MohamedHassan-coder/5-Axis-CNC/Linear_Guide & Rails/Linear Bearing in Guide Rail - 20mm.JPG

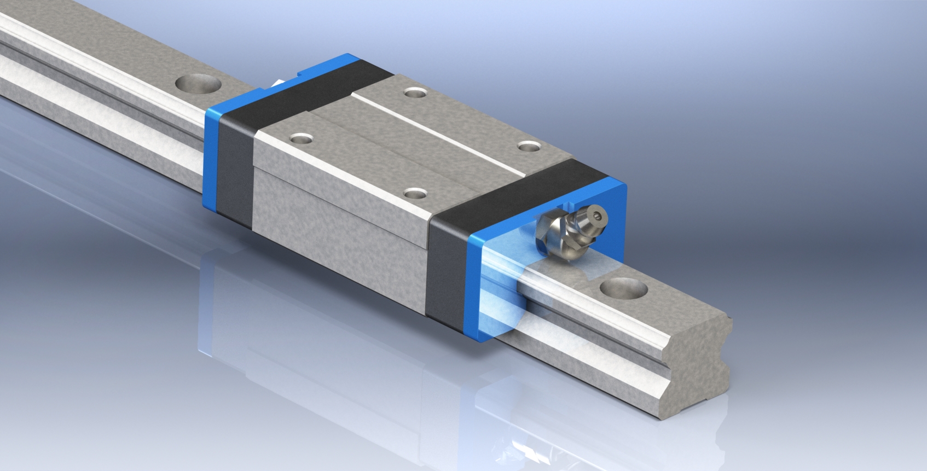
Linear_Guide & Rails/Linear Bearing in Guide Rail - 20mm.JPG
