MohamedHassan-coder/5-Axis-CNC/Linear_Guide & Rails/Linear Bearing - 20mm.JPG

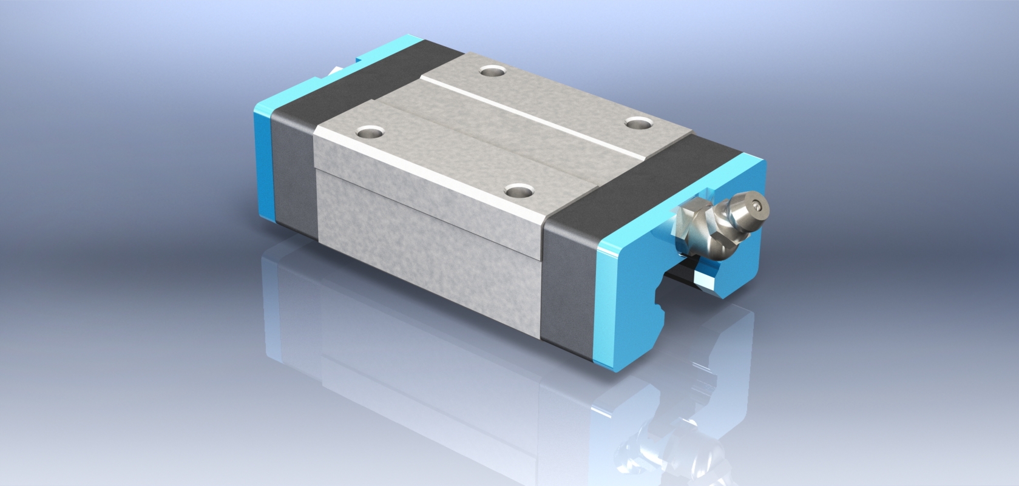
Linear_Guide & Rails/Linear Bearing - 20mm.JPG
