MohamedHassan-coder/5-Axis-CNC/Collet & Chuck/Capture- 1.PNG

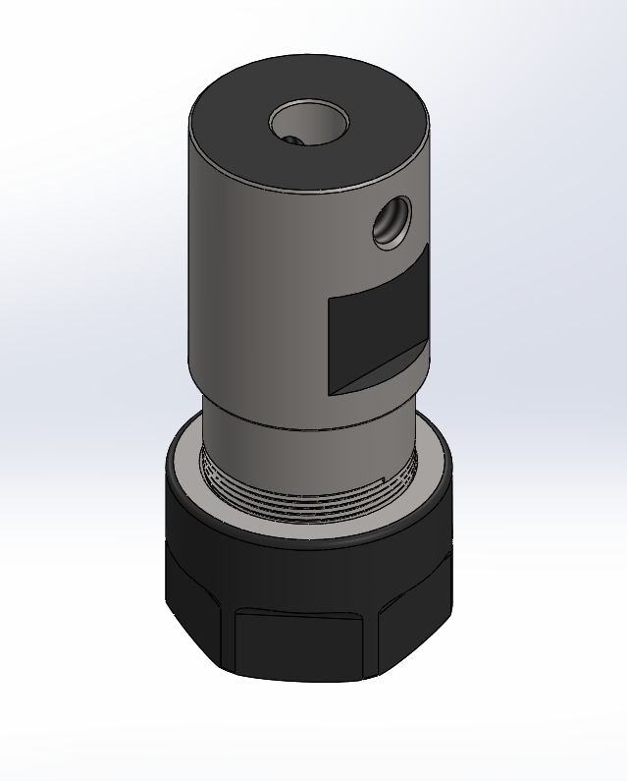
Collet & Chuck/Capture- 1.PNG
