MohamedHassan-coder/5-Axis-CNC/Collet & Chuck/Capture- 2.PNG

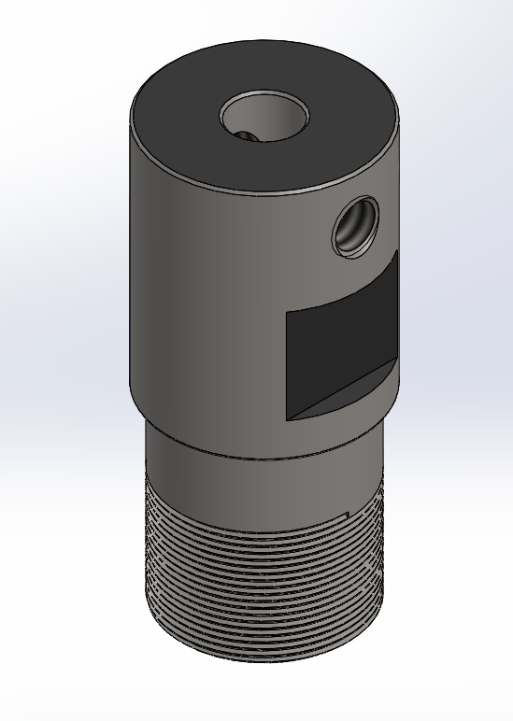
Collet & Chuck/Capture- 2.PNG
