MohamedHassan-coder/5-Axis-CNC/Collet & Chuck/Capture- 3.PNG

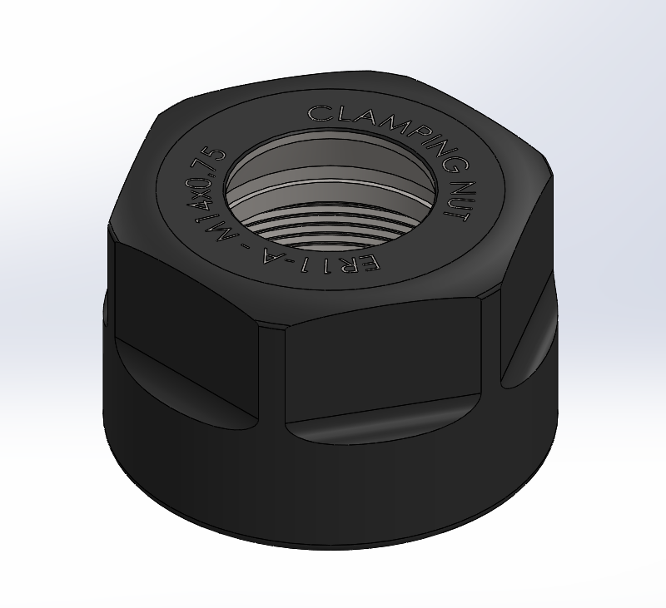
Collet & Chuck/Capture- 3.PNG
