MohamedHassan-coder/5-Axis-CNC/Collet & Chuck/ER11 Collet Set.png

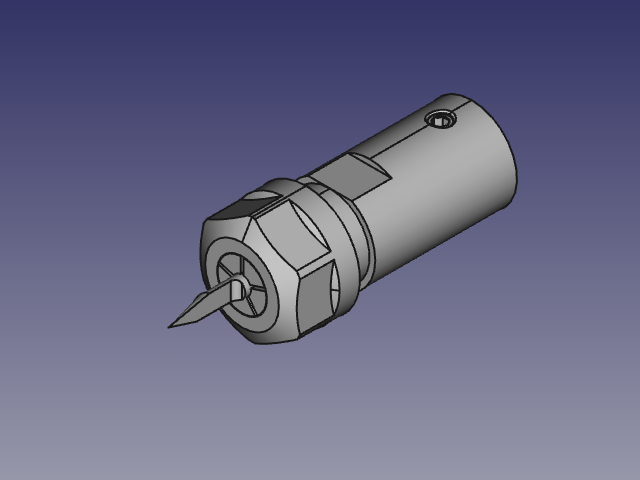
Collet & Chuck/ER11 Collet Set.png
