MohamedHassan-coder/5-Axis-CNC/Lead Screw & Nut/LeadScrew 8mm x 2mmPitch.JPG

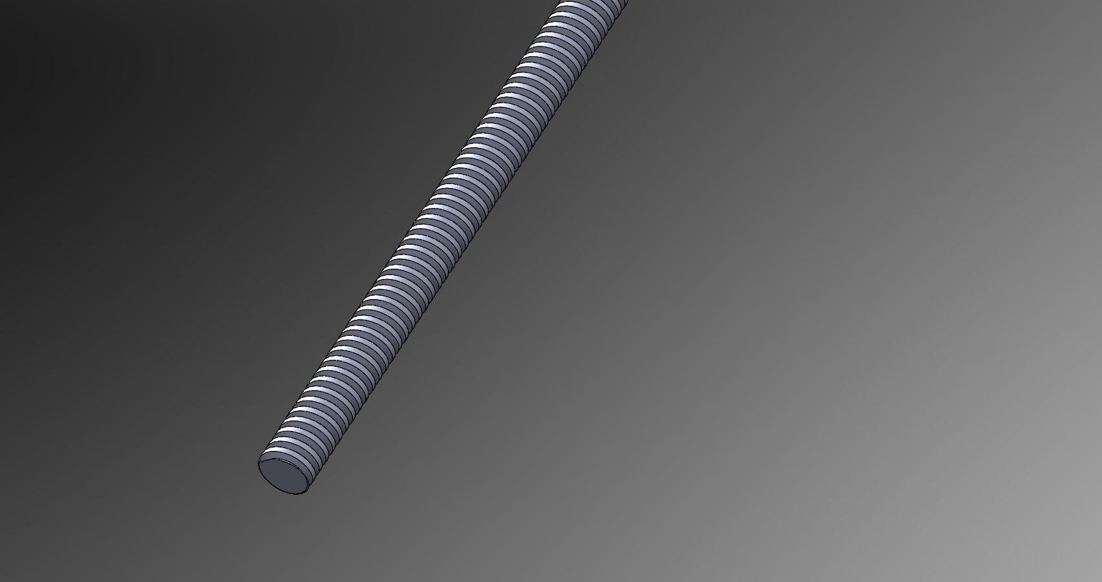
Lead Screw & Nut/LeadScrew 8mm x 2mmPitch.JPG
