MohamedHassan-coder/5-Axis-CNC/Motors/Nema 17/Nema 17 Steper Motor.JPG

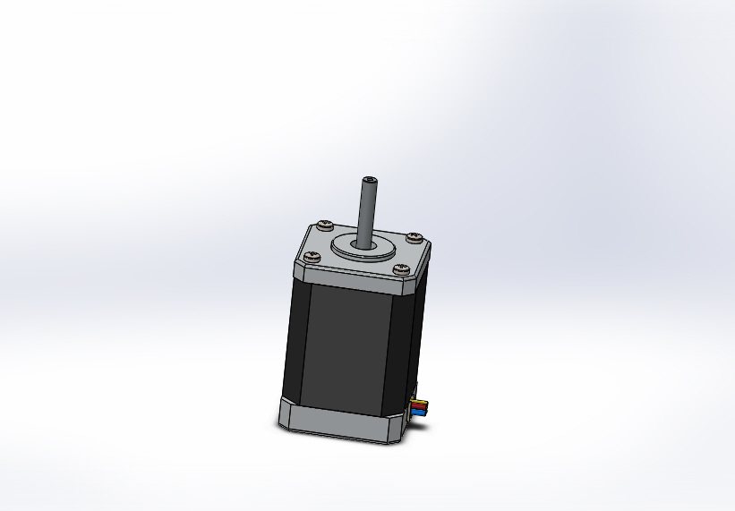
Motors/Nema 17/Nema 17 Steper Motor.JPG
