MohamedHassan-coder/5-Axis-CNC/Main Assembly/Nut&Housing.SLDASM

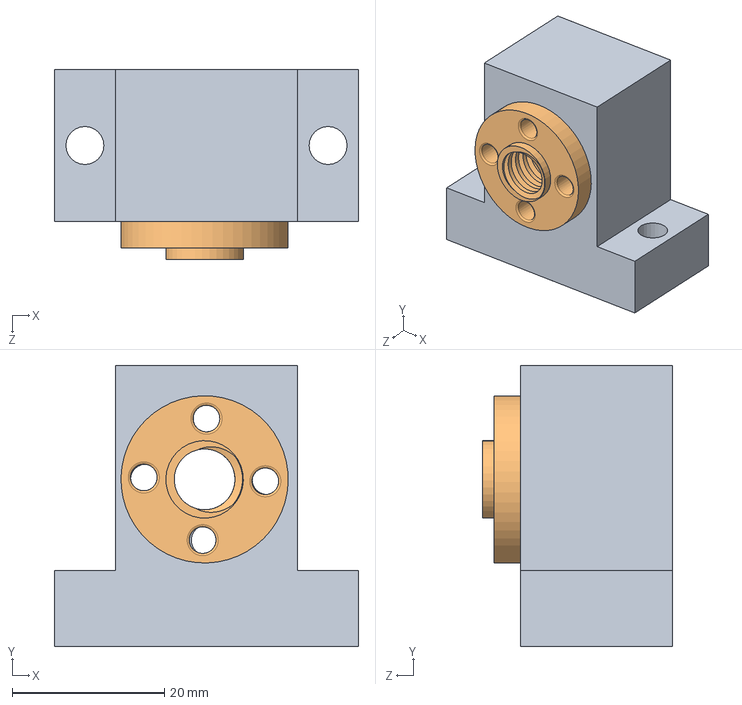
[picture p77: CAD file, 2022-07-14]
Main Assembly/Nut&Housing.SLDASM
40.0 x 37.0 x 25.0 mm
Lead Screw Nut_Housing(Z_Axis)
LeadScrew Nut 8mm x 2mmPitch
