MohamedHassan-coder/5-Axis-CNC/5 Axis Extension/A-Axis Assembly.SLDASM

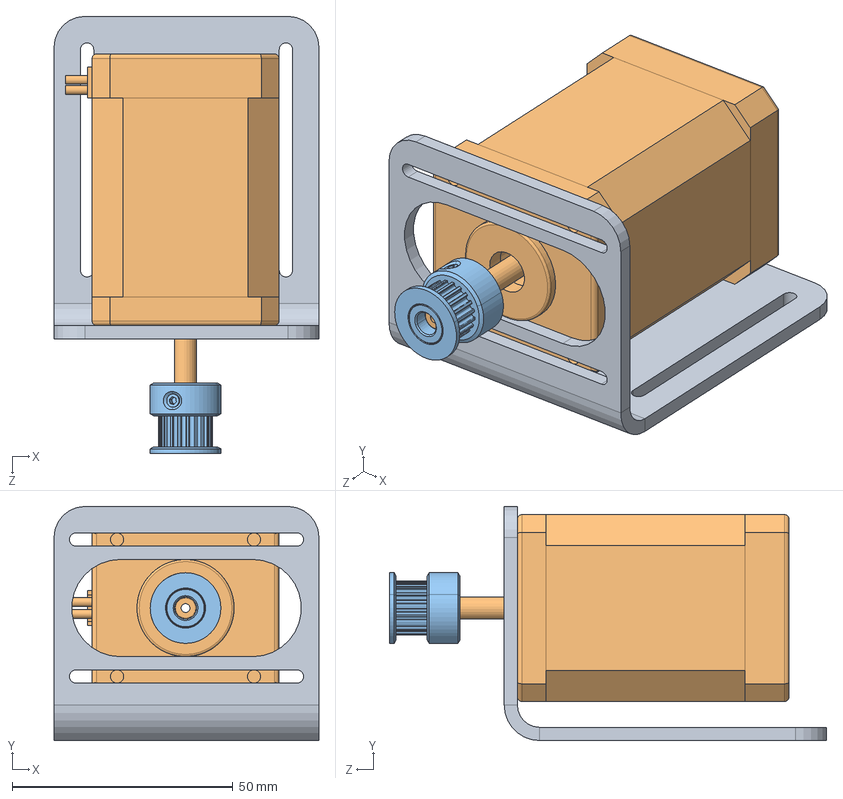
[picture p78: CAD file, 2022-07-14]
5 Axis Extension/A-Axis Assembly.SLDASM
60.0 x 53.0 x 99.0 mm
A-Axis Motor Base(SM)
Nema 17
GT2_20T
