MohamedHassan-coder/5-Axis-CNC/Chuck/Chuck.SLDASM

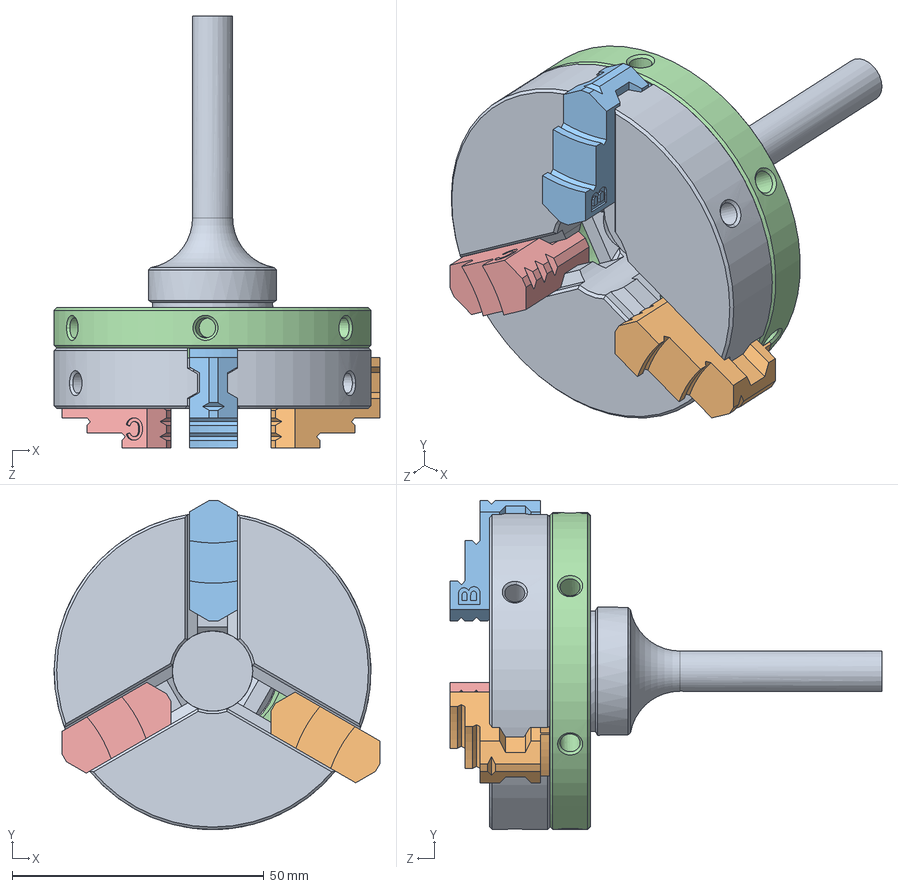
[picture p79: CAD file, 2022-03-02]
Chuck/Chuck.SLDASM
64.8 x 65.4 x 85.9 mm
Housing
JAW_A
JAW_B
Scroll_Plate
JAW_C
