MohamedHassan-coder/5-Axis-CNC/Main Assembly/M-C_Main_Controller_SM.SLDASM

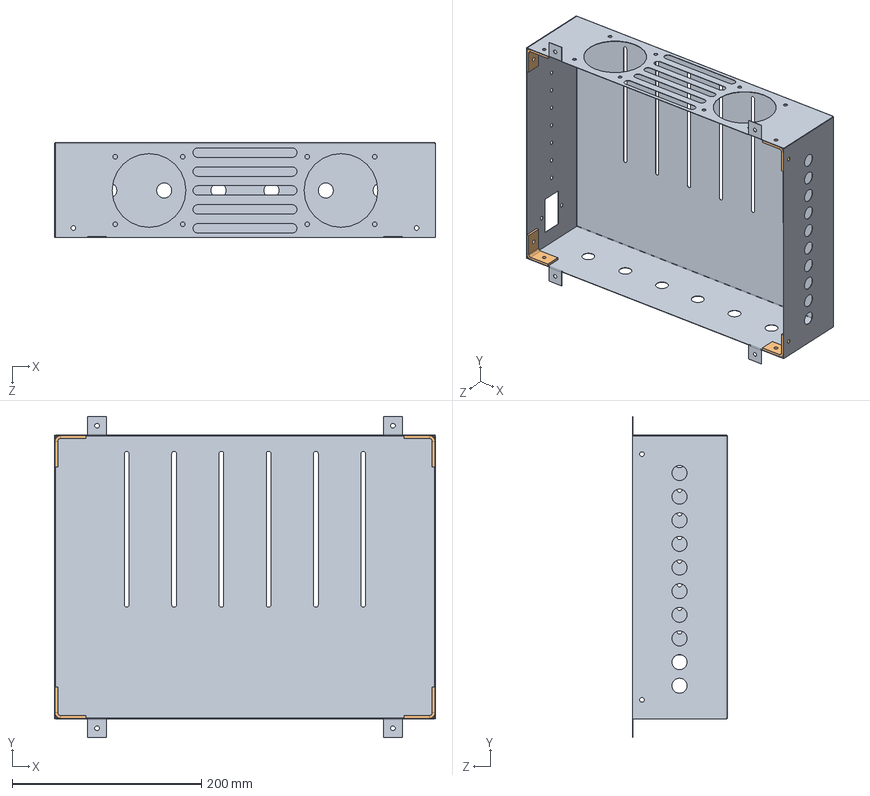
[picture p80: CAD file, 2022-07-14]
Main Assembly/M-C_Main_Controller_SM.SLDASM
403.0 x 340.0 x 100.5 mm
Sheet_Metal Version
Walls_fixation x 4
