MohamedHassan-coder/5-Axis-CNC/5 Axis Extension/C-Axis Assembly.SLDASM

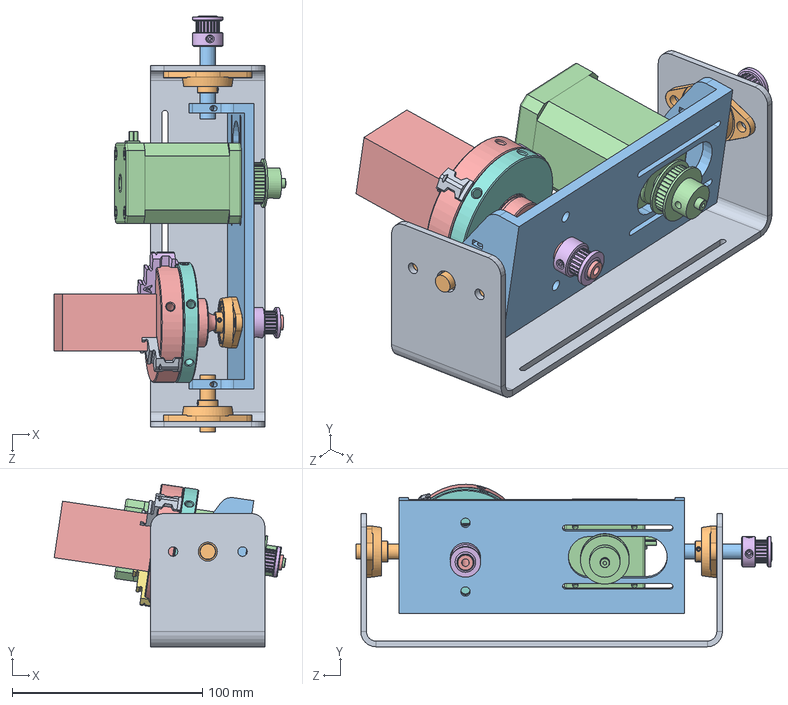
[picture p81: CAD file, 2022-07-14]
5 Axis Extension/C-Axis Assembly.SLDASM
121.7 x 85.4 x 218.5 mm
C-Axis Base
Lead_Screw_End_Support_KFL08 x 3
C-Axis Rotate Part
Nema 17
Housing
JAW_A
JAW_B
Scroll_Plate
JAW_C
C-Axis Rod1
C-Axis Rod2
GT2 36T id 5mm bw 6mm
WP
GT2_20T-sh8 x 2
