MohamedHassan-coder/5-Axis-CNC/Main Assembly/Limit_Switches_Fan.SLDASM

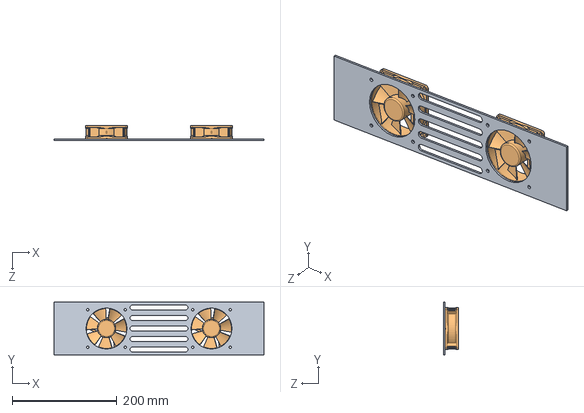
[picture p82: CAD file, 2022-07-14]
Main Assembly/Limit_Switches_Fan.SLDASM
400.0 x 100.0 x 28.4 mm
Fan_Side
8412NGLE_EBM-PAPST x 2
