MohamedHassan-coder/5-Axis-CNC/Main Assembly/LM8SUU&Housing.SLDASM

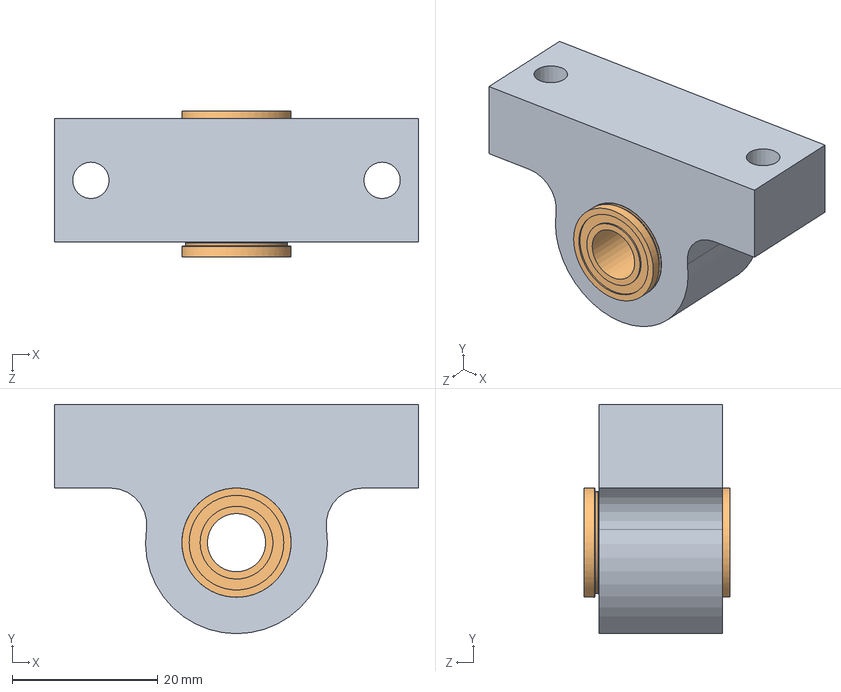
[picture p83: CAD file, 2022-07-14]
Main Assembly/LM8SUU&Housing.SLDASM
50.0 x 31.5 x 20.0 mm
LM8LUU Housing
LM8UU
