MohamedHassan-coder/5-Axis-CNC/Main Assembly/Limit_Switches_Assembly.SLDASM

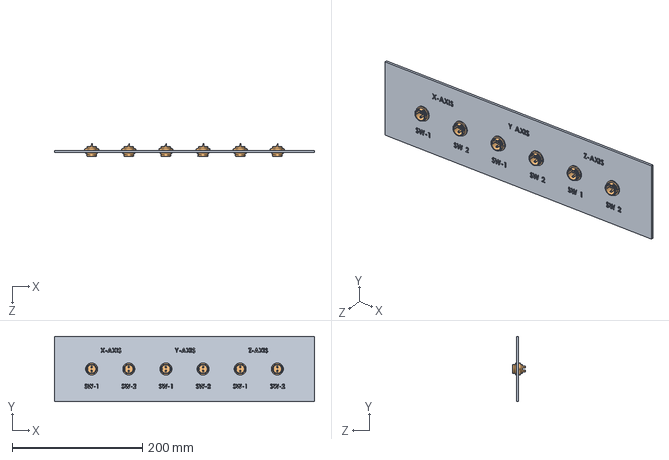
[picture p84: CAD file, 2022-07-14]
Main Assembly/Limit_Switches_Assembly.SLDASM
400.0 x 100.0 x 20.0 mm
Limit_SW_Side
GX-16 Connector 2 Pins x 6
