MohamedHassan-coder/5-Axis-CNC/Other Parts/Limit_SW & Support .SLDASM

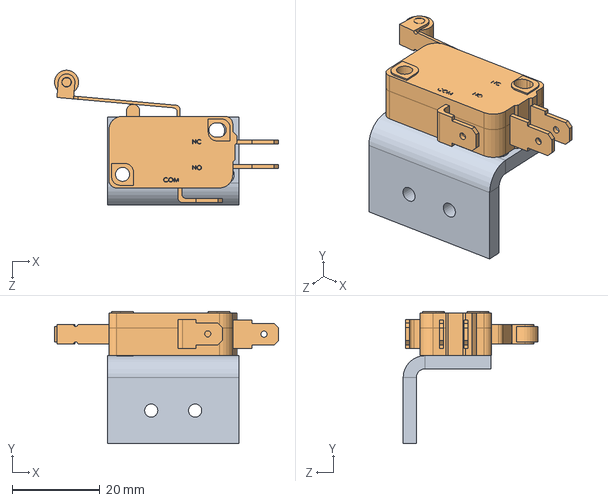
[picture p85: CAD file, 2022-07-14]
Other Parts/Limit_SW & Support .SLDASM
51.0 x 30.0 x 30.7 mm
Limit Switch Support
Switch SV-166-1C25
