MohamedHassan-coder/5-Axis-CNC/Main Assembly/Frame Assembly(For Simulation).SLDASM

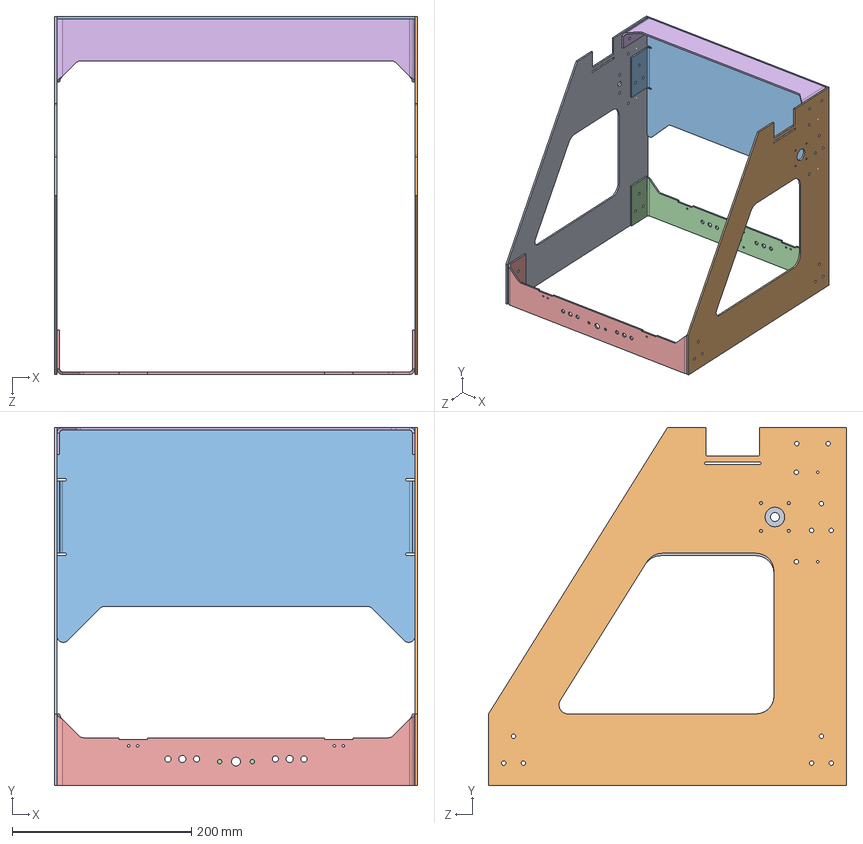
[picture p86: CAD file, 2022-02-26]
Main Assembly/Frame Assembly(For Simulation).SLDASM
406.0 x 400.0 x 400.0 mm
X_Bearing_Side
X_Stepper_Side
Back_Support_Top
Y_Stepper_Side
Y_Bearing_Side
Roof_Support
