MohamedHassan-coder/5-Axis-CNC/Motors/Nema 17/Nema 17 Steper Motor.SLDASM

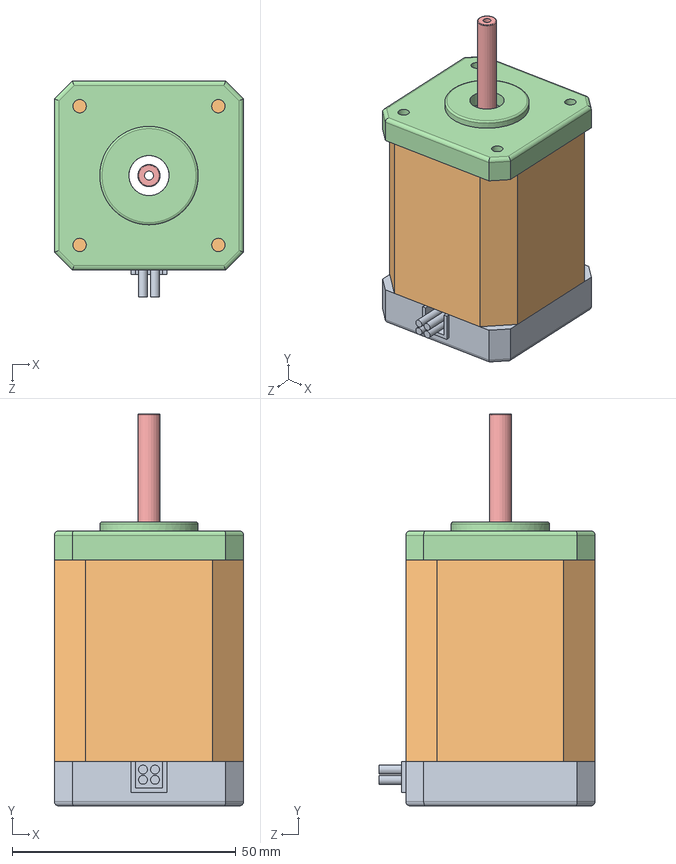
[picture p87: CAD file, 2022-02-13]
Motors/Nema 17/Nema 17 Steper Motor.SLDASM
42.3 x 87.6 x 48.3 mm
Bottom Body
Middle Body
pan cross head_am x 4
Upper Body
Stepper Ass
