MohamedHassan-coder/5-Axis-CNC/Main Assembly/Cutting_Part.SLDASM

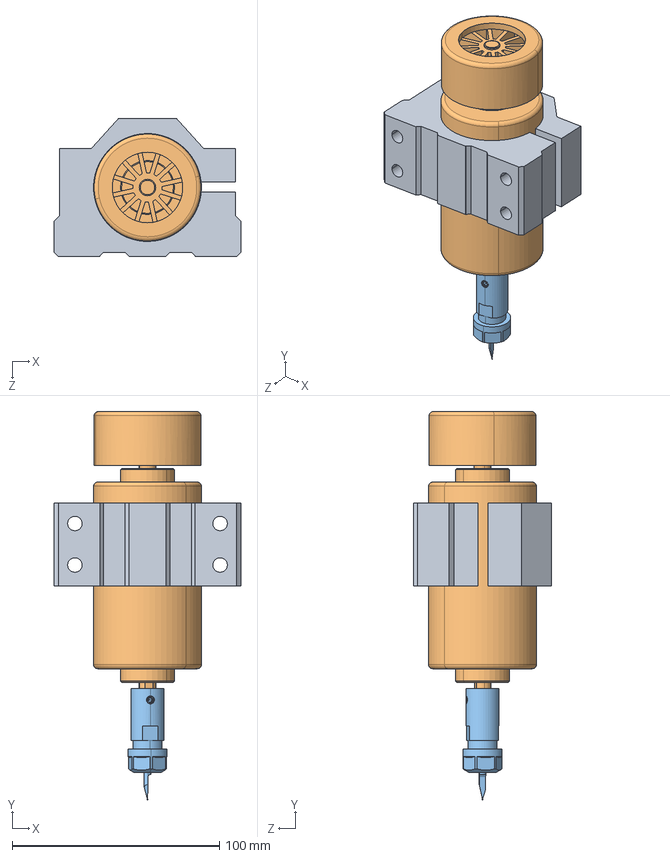
[picture p88: CAD file, 2022-02-22]
Main Assembly/Cutting_Part.SLDASM
90.0 x 187.0 x 66.5 mm
Spindle_Mount
MotorDC300W(Spindle)
ER11-A Collet Set
