MohamedHassan-coder/5-Axis-CNC/Main Assembly/Main Assembly.SLDASM

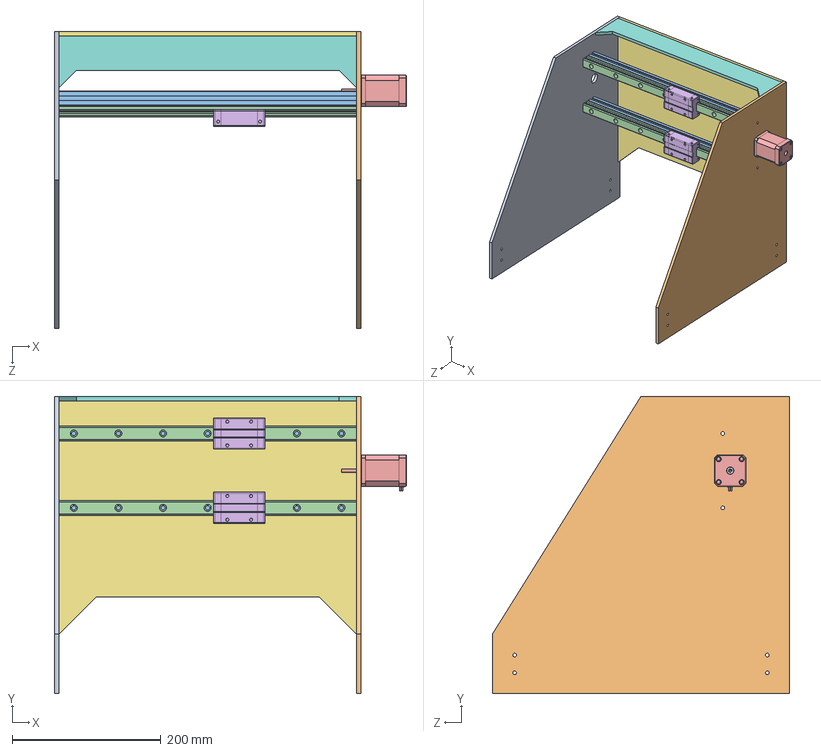
[picture p89: CAD file, 2022-02-14]
Main Assembly/Main Assembly.SLDASM
473.5 x 400.0 x 400.0 mm
X_Bearing_Side
X_Stepper_Side
2020 alu section x 2
Linear bearing Rail 20mm x 2
Nema 17
Linear Bearing Block QEH20CA x 2
Back_Support_Top
Roof_Support
