MohamedHassan-coder/5-Axis-CNC/5 Axis Extension/A-Axis Motor Base(SM).SLDPRT

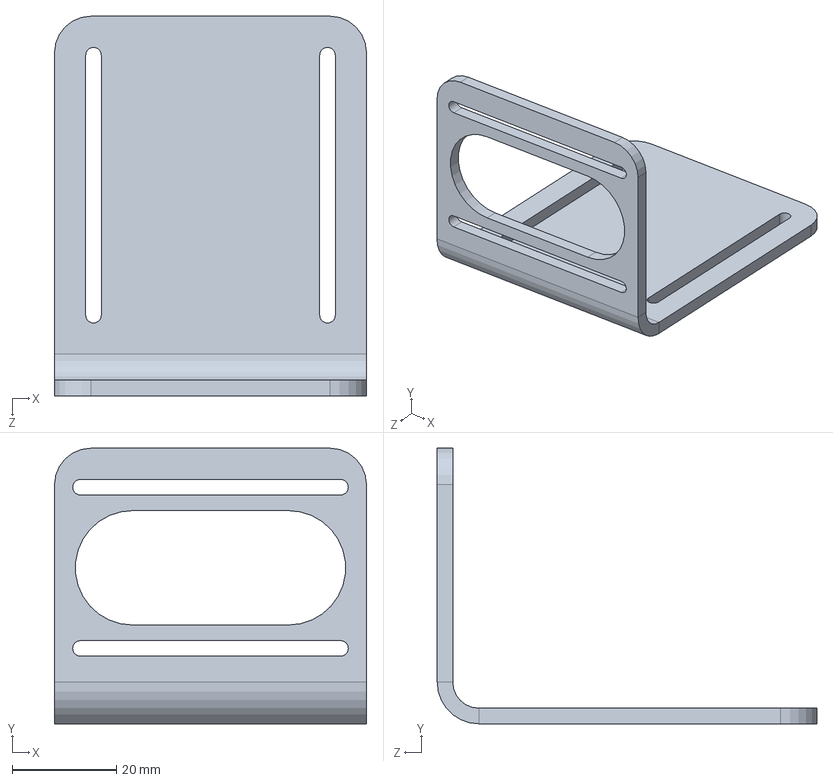
[picture p90: CAD file, 2022-07-14]
5 Axis Extension/A-Axis Motor Base(SM).SLDPRT
60.0 x 53.0 x 73.0 mm
