MohamedHassan-coder/5-Axis-CNC/Aluminum Profiles/2020/2020 alu section (170 mm).SLDPRT

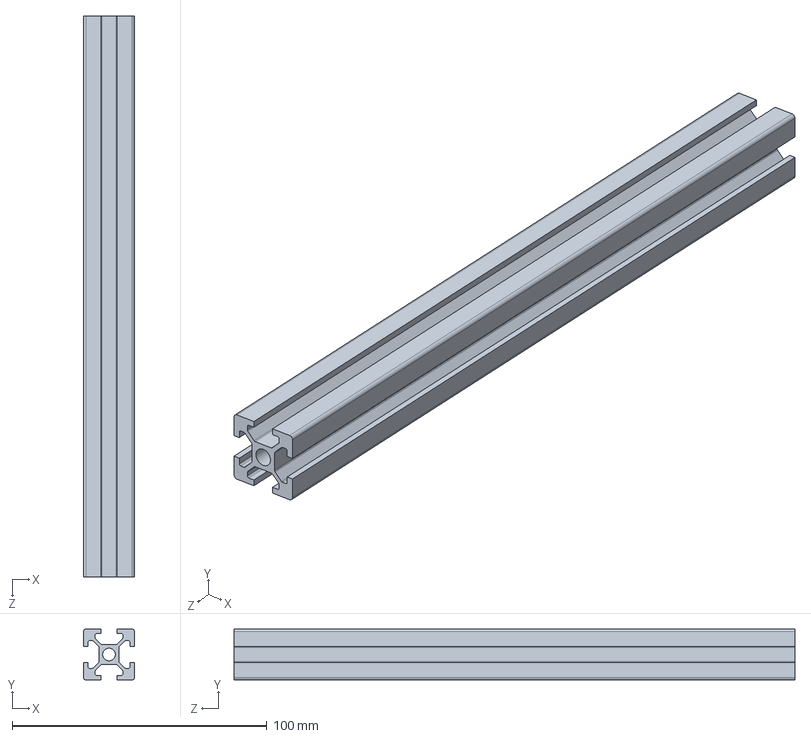
[picture p91: CAD file, 2022-02-22]
Aluminum Profiles/2020/2020 alu section (170 mm).SLDPRT
20.0 x 20.0 x 220.0 mm
