MohamedHassan-coder/5-Axis-CNC/Chuck/Housing.SLDPRT

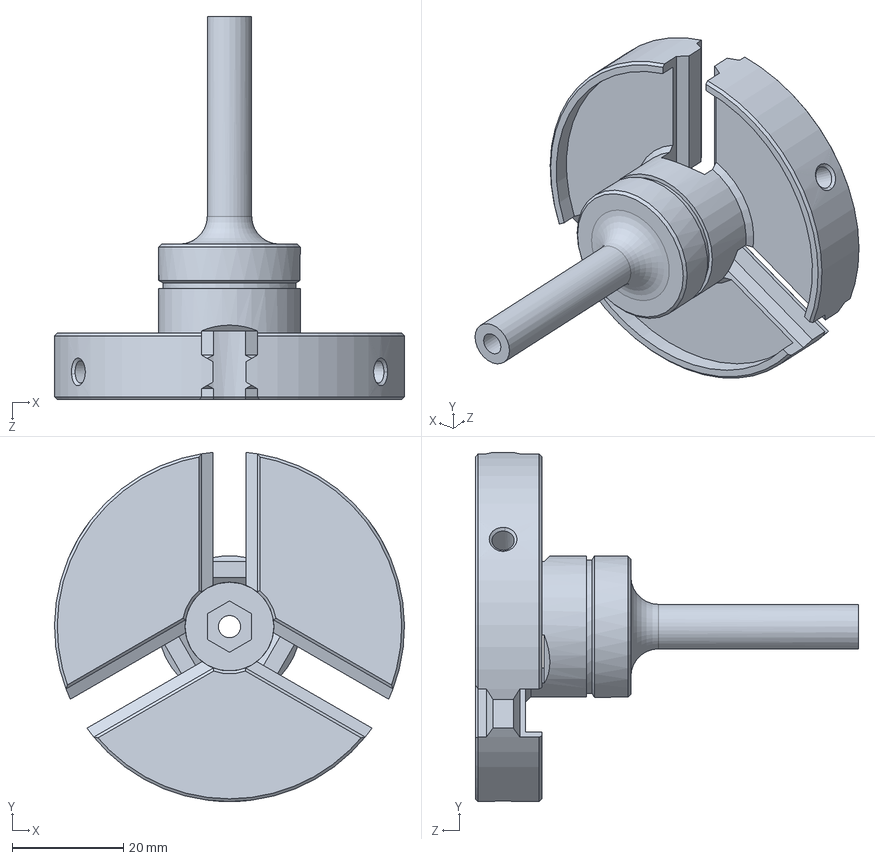
[picture p92: CAD file, 2022-03-03]
Chuck/Housing.SLDPRT
63.0 x 62.9 x 69.0 mm
