MohamedHassan-coder/5-Axis-CNC/Collet & Chuck/ER11-A Collet Set.STEP

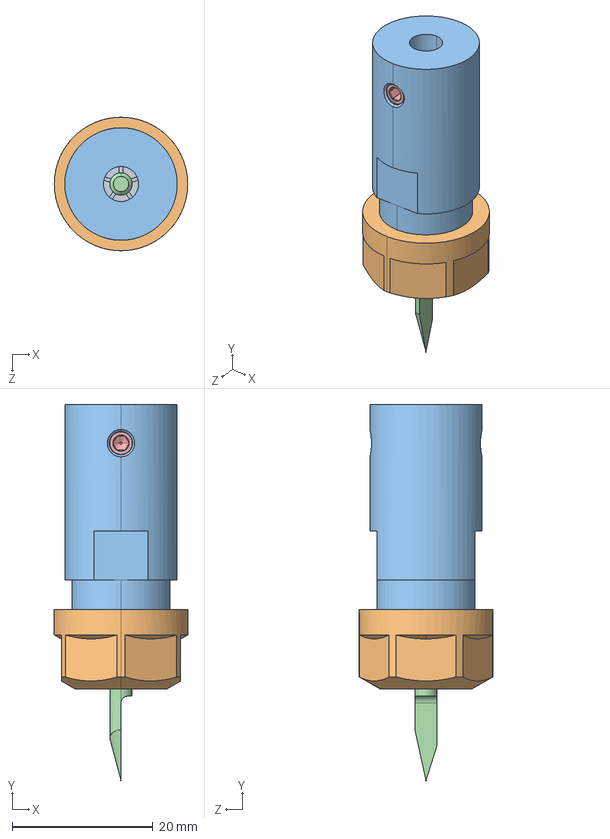
[picture p93: CAD file, 2022-02-19]
Collet & Chuck/ER11-A Collet Set.STEP
19.0 x 53.5 x 19.0 mm
Body.step
Cut.step
Body003.step
Cut001.step
M4x5-Screw.step
M4x5-Screw001.step
