MohamedHassan-coder/5-Axis-CNC/Control Box/Power Supply Fixation.SLDPRT

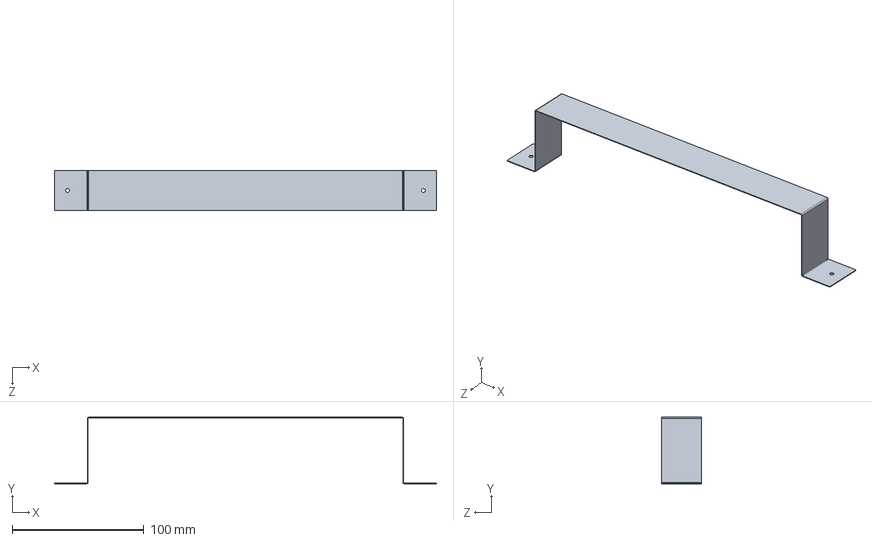
[picture p94: CAD file, 2022-07-14]
Control Box/Power Supply Fixation.SLDPRT
290.0 x 50.5 x 30.0 mm
