MohamedHassan-coder/5-Axis-CNC/Couplings/CouplingD19L25.step

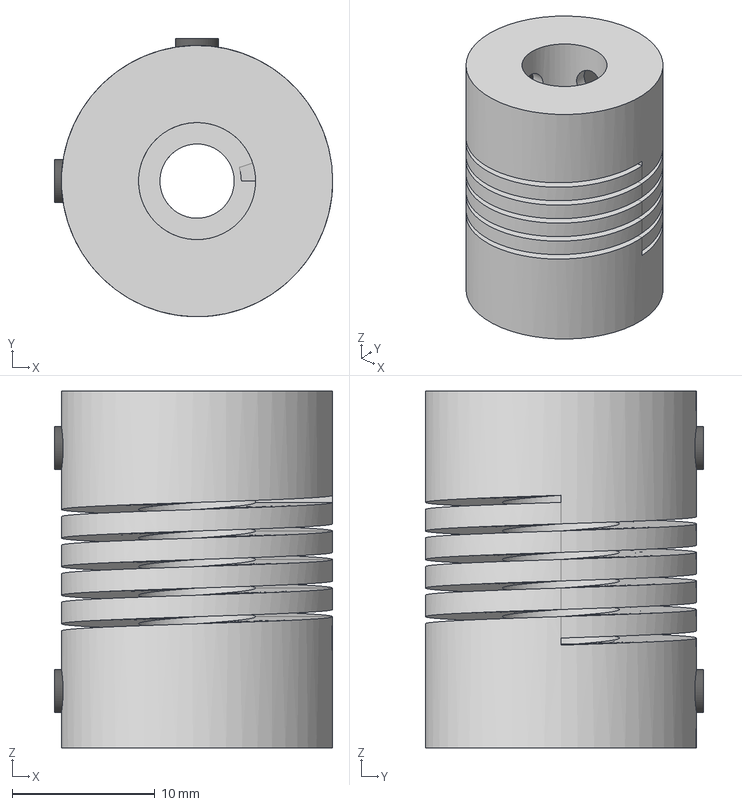
[picture p95: CAD file, 2022-02-13]
Couplings/CouplingD19L25.step
19.5 x 19.5 x 25.0 mm
MainAxis
