MohamedHassan-coder/5-Axis-CNC/Linear_Guide & Rails/HGH20CA.SLDPRT

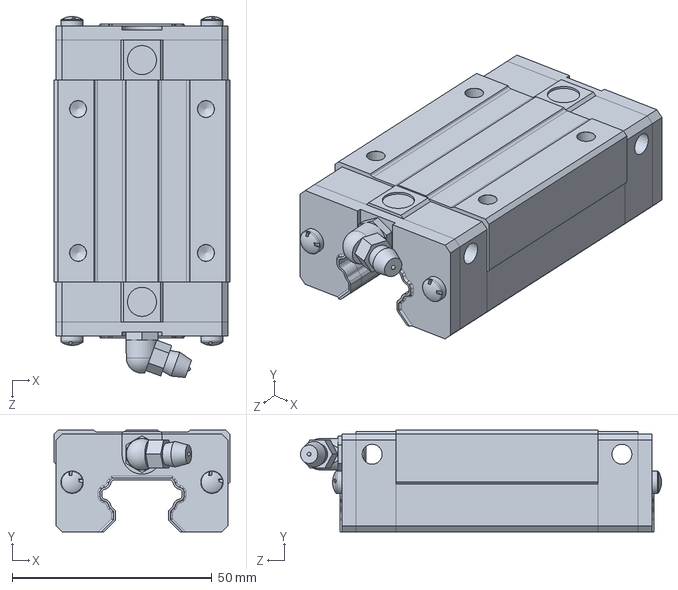
[picture p96: CAD file, 2022-07-14]
Linear_Guide & Rails/HGH20CA.SLDPRT
44.0 x 25.4 x 90.3 mm
