MohamedHassan-coder/5-Axis-CNC/Main Frame/Side_Panel_New.SLDPRT

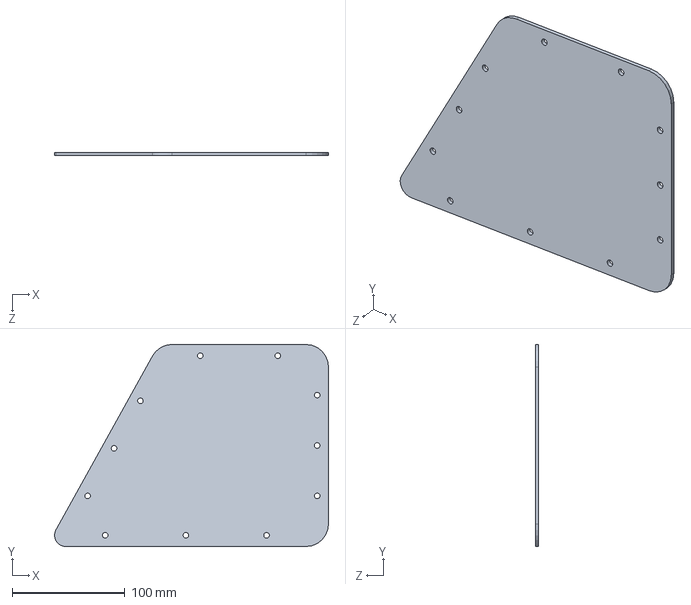
[picture p97: CAD file, 2022-07-14]
Main Frame/Side_Panel_New.SLDPRT
243.4 x 179.5 x 3.00 mm
