MohamedHassan-coder/5-Axis-CNC/Motors/MotorDC300W(Spindle).SLDPRT

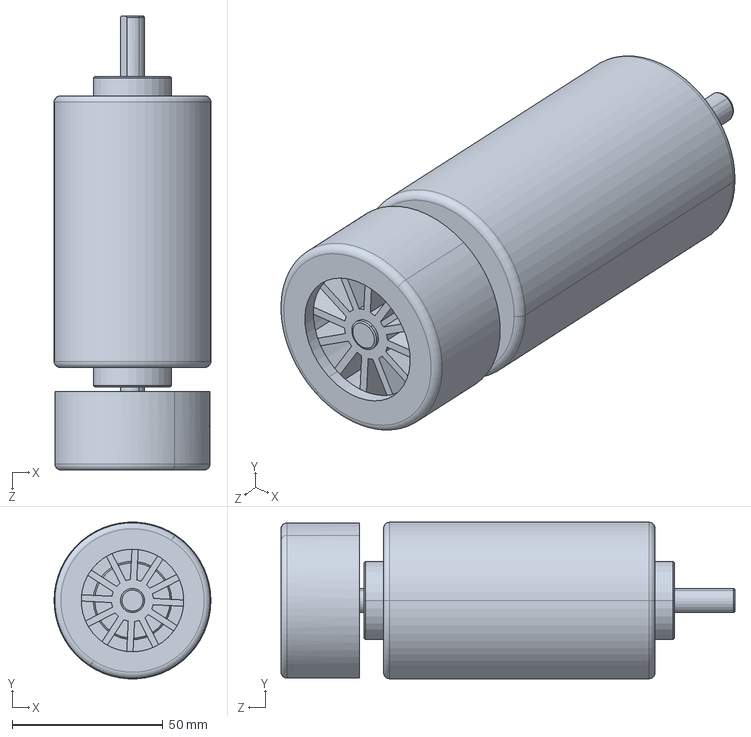
[picture p98: CAD file, 2022-02-19]
Motors/MotorDC300W(Spindle).SLDPRT
52.0 x 51.9 x 150.5 mm
