MohamedHassan-coder/5-Axis-CNC/Other Parts/LM8LUU Housing.SLDPRT

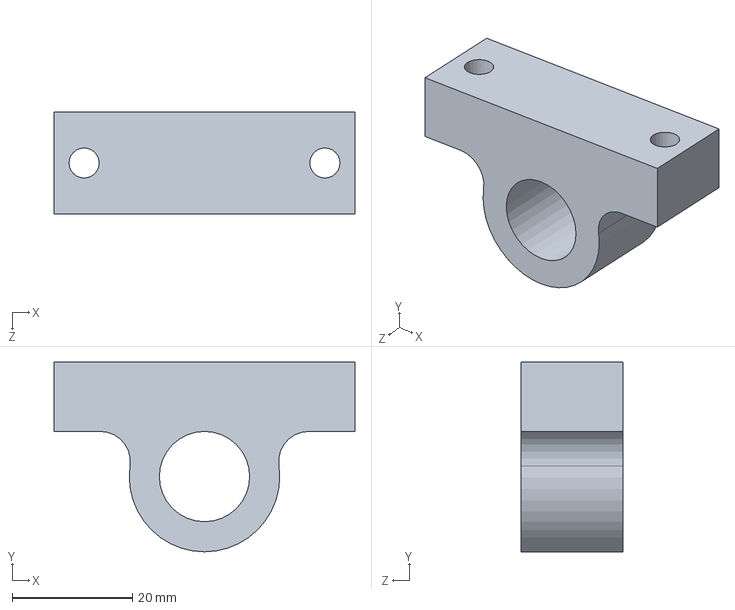
[picture p99: CAD file, 2022-07-14]
Other Parts/LM8LUU Housing.SLDPRT
50.0 x 31.5 x 17.0 mm
