MohamedHassan-coder/5-Axis-CNC/Shaft/Door_Rotation_Shaft.SLDPRT

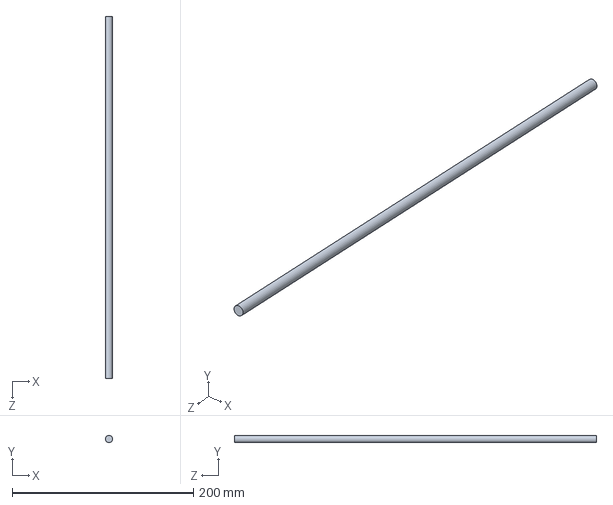
[picture p100: CAD file, 2022-02-15]
Shaft/Door_Rotation_Shaft.SLDPRT
8.00 x 8.00 x 400.0 mm
