MohamedHassan-coder/5-Axis-CNC/Shaft/Fixations/SHF8.SLDPRT

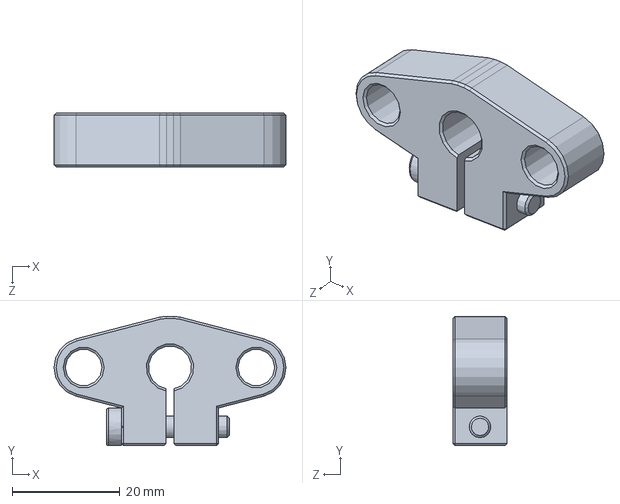
[picture p101: CAD file, 2022-02-15]
Shaft/Fixations/SHF8.SLDPRT
43.0 x 24.0 x 10.0 mm
