MohamedHassan-coder/5-Axis-CNC/Aluminum Profiles/2020/2020 alu section.SLDPRT

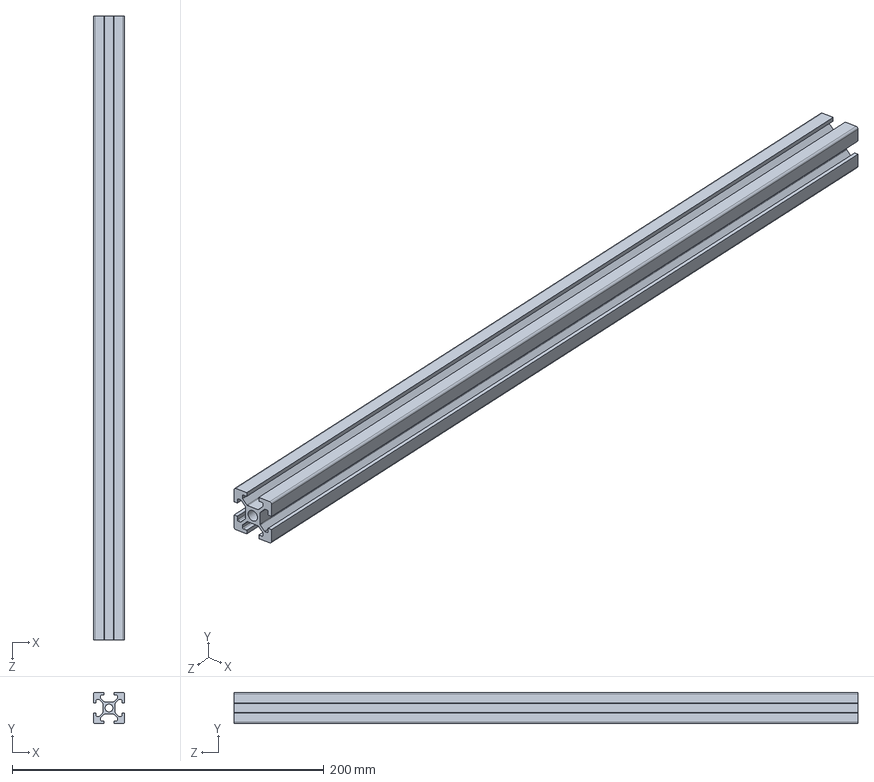
[picture p102: CAD file, 2022-02-12]
Aluminum Profiles/2020/2020 alu section.SLDPRT
20.0 x 20.0 x 400.0 mm
