MohamedHassan-coder/5-Axis-CNC/Bearings/LM8UU.SLDPRT

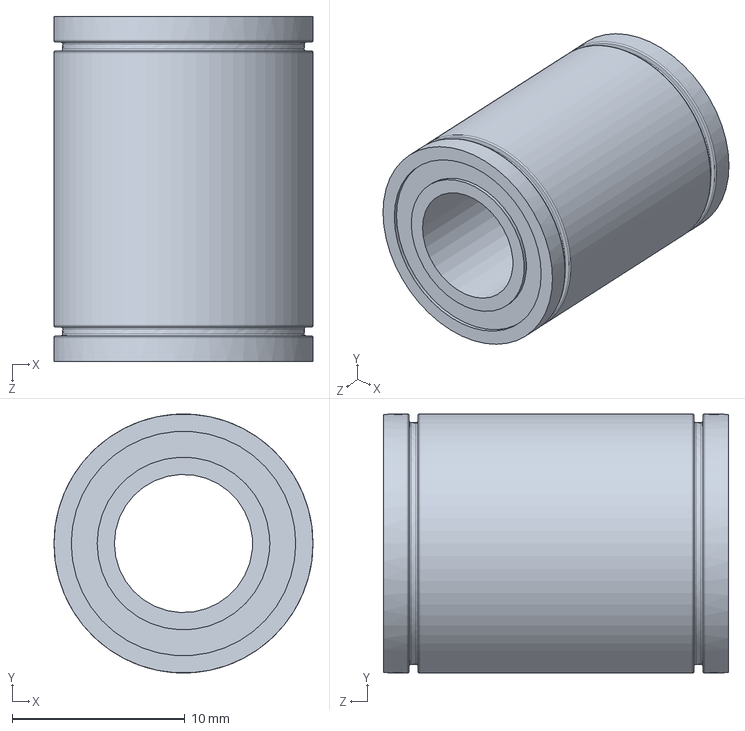
[picture p103: CAD file, 2022-02-12]
Bearings/LM8UU.SLDPRT
15.0 x 15.0 x 20.0 mm
