MohamedHassan-coder/5-Axis-CNC/Control Box/Limit_SW_Side.SLDPRT

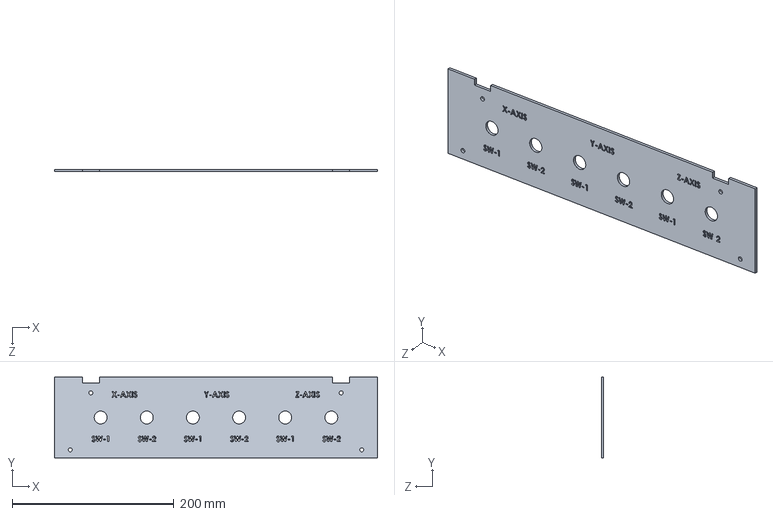
[picture p104: CAD file, 2022-07-14]
Control Box/Limit_SW_Side.SLDPRT
400.0 x 100.0 x 3.00 mm
