MohamedHassan-coder/5-Axis-CNC/Linear_Guide & Rails/Linear bearing Rail 20mm(170 mm).SLDPRT

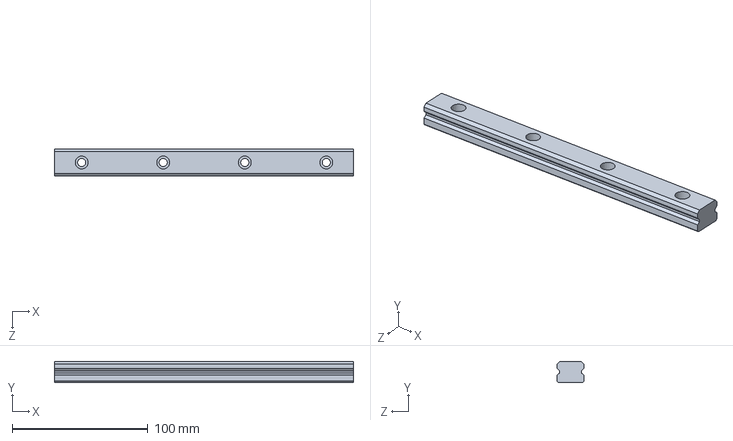
[picture p105: CAD file, 2022-02-22]
Linear_Guide & Rails/Linear bearing Rail 20mm(170 mm).SLDPRT
220.0 x 15.5 x 20.0 mm
