MohamedHassan-coder/5-Axis-CNC/Main Frame/Taple_Fixation.SLDPRT

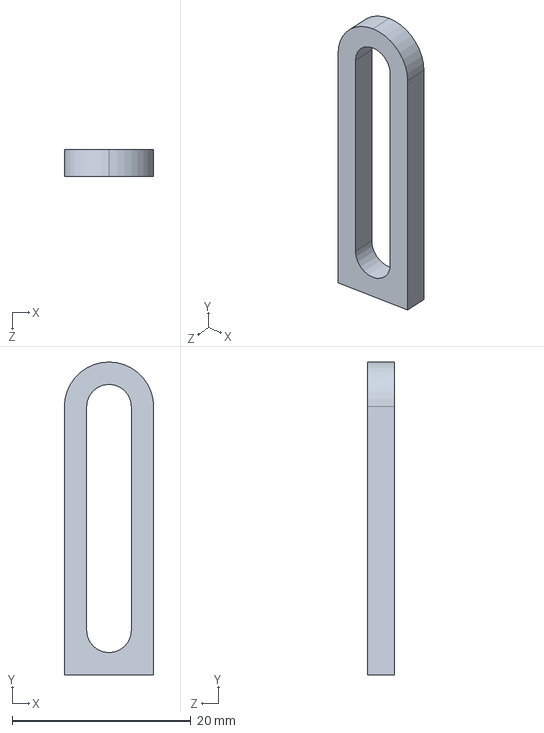
[picture p106: CAD file, 2022-07-14]
Main Frame/Taple_Fixation.SLDPRT
10.0 x 35.0 x 3.00 mm
