MohamedHassan-coder/5-Axis-CNC/Motors/Nema 17/Middle Body.SLDPRT

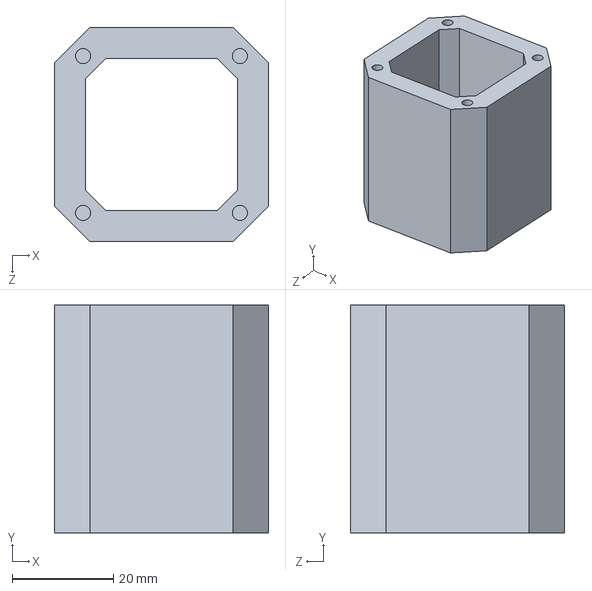
[picture p107: CAD file, 2022-02-13]
Motors/Nema 17/Middle Body.SLDPRT
42.3 x 45.0 x 42.3 mm
