MohamedHassan-coder/5-Axis-CNC/Motors/Spindle_Mount.SLDPRT

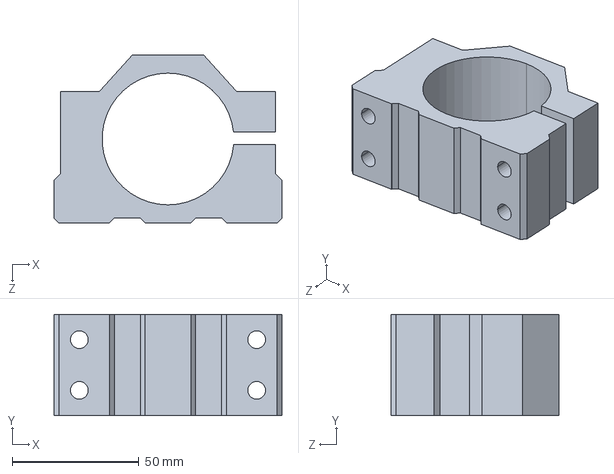
[picture p108: CAD file, 2022-02-19]
Motors/Spindle_Mount.SLDPRT
90.0 x 40.0 x 66.5 mm
