MohamedHassan-coder/5-Axis-CNC/Other Parts/Bits Holder.SLDPRT

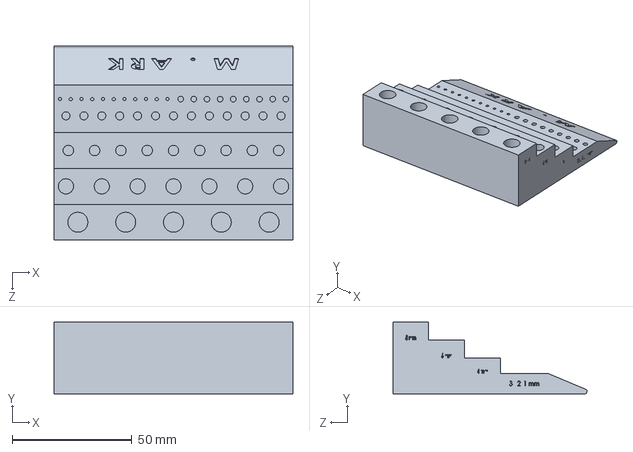
[picture p109: CAD file, 2022-07-14]
Other Parts/Bits Holder.SLDPRT
100.0 x 30.0 x 81.3 mm
