MohamedHassan-coder/5-Axis-CNC/Chuck/JAW_C.SLDPRT

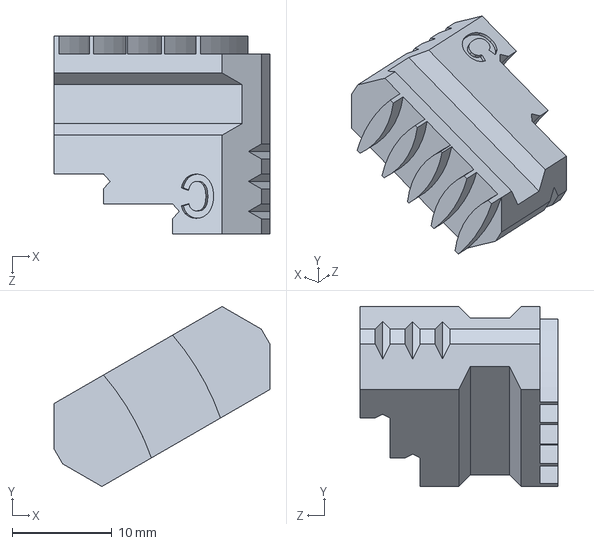
[picture p110: CAD file, 2022-03-01]
Chuck/JAW_C.SLDPRT
21.7 x 18.0 x 19.8 mm
