MohamedHassan-coder/5-Axis-CNC/Control Box/Walls_fixation.SLDPRT

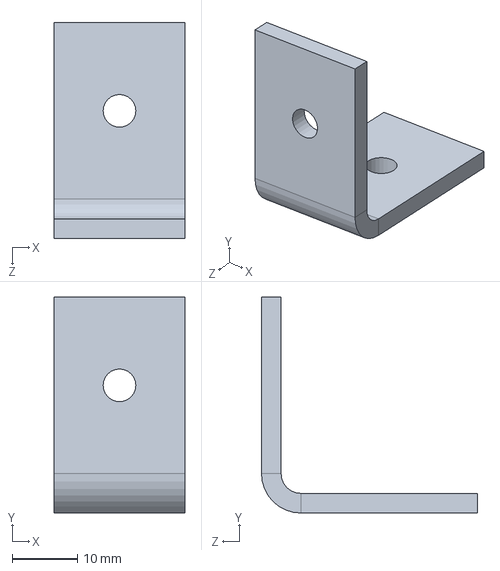
[picture p111: CAD file, 2022-07-14]
Control Box/Walls_fixation.SLDPRT
20.0 x 33.0 x 33.0 mm
