MohamedHassan-coder/5-Axis-CNC/Linear_Guide & Rails/Linear bearing Rail 20mm.SLDPRT

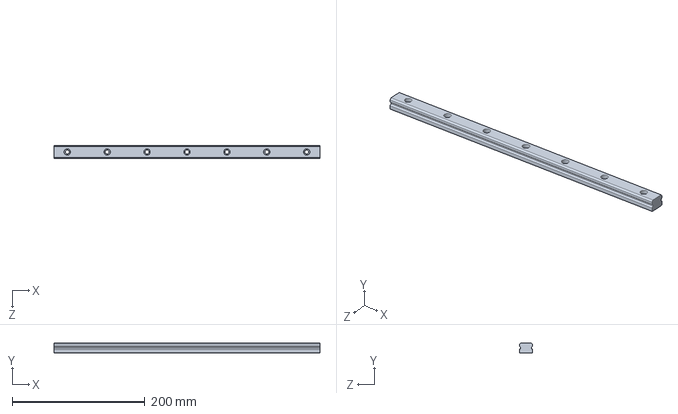
[picture p112: CAD file, 2022-02-13]
Linear_Guide & Rails/Linear bearing Rail 20mm.SLDPRT
400.0 x 15.5 x 20.0 mm
