MohamedHassan-coder/5-Axis-CNC/Main Frame/Side_Panel.SLDPRT

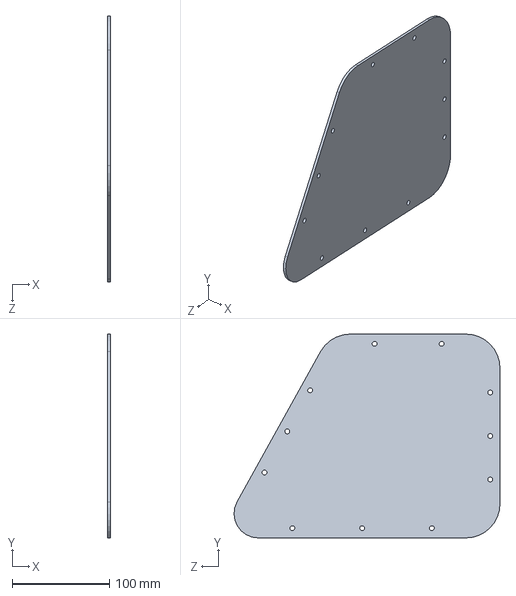
[picture p113: CAD file, 2022-07-14]
Main Frame/Side_Panel.SLDPRT
3.00 x 209.5 x 273.4 mm
