MohamedHassan-coder/5-Axis-CNC/Motors/Nema 17/Upper Body.SLDPRT

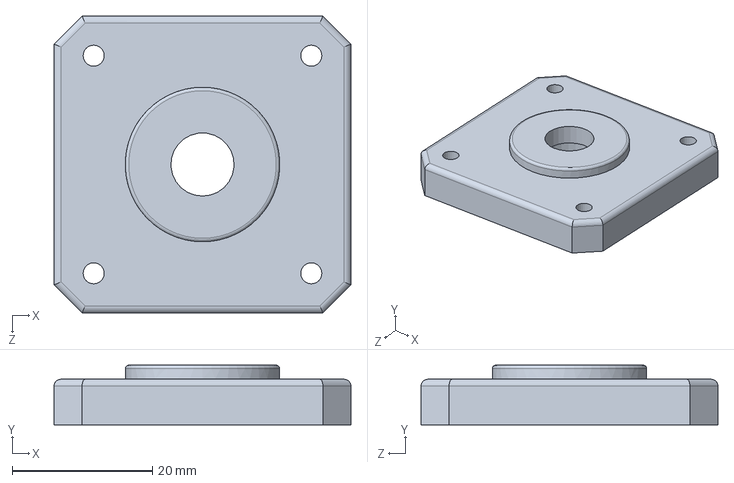
[picture p114: CAD file, 2022-02-13]
Motors/Nema 17/Upper Body.SLDPRT
42.3 x 8.50 x 42.3 mm
