MohamedHassan-coder/5-Axis-CNC/Other Parts/Waste Borde.SLDPRT

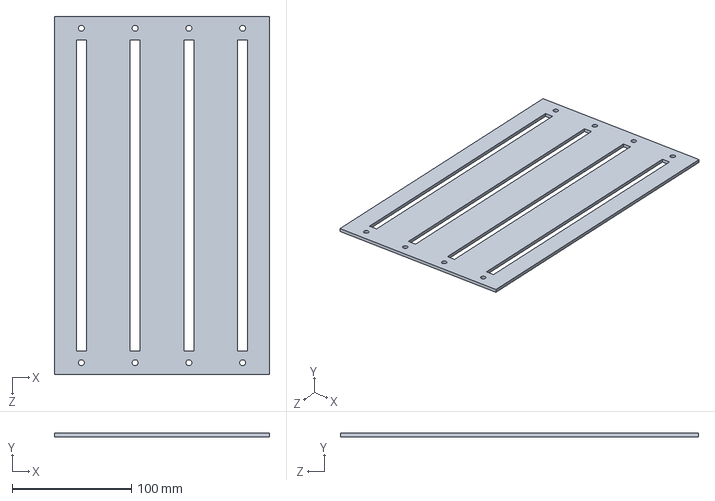
[picture p115: CAD file, 2022-07-14]
Other Parts/Waste Borde.SLDPRT
180.0 x 3.00 x 300.0 mm
