MohamedHassan-coder/5-Axis-CNC/5 Axis Extension/C-Axis Base.SLDPRT

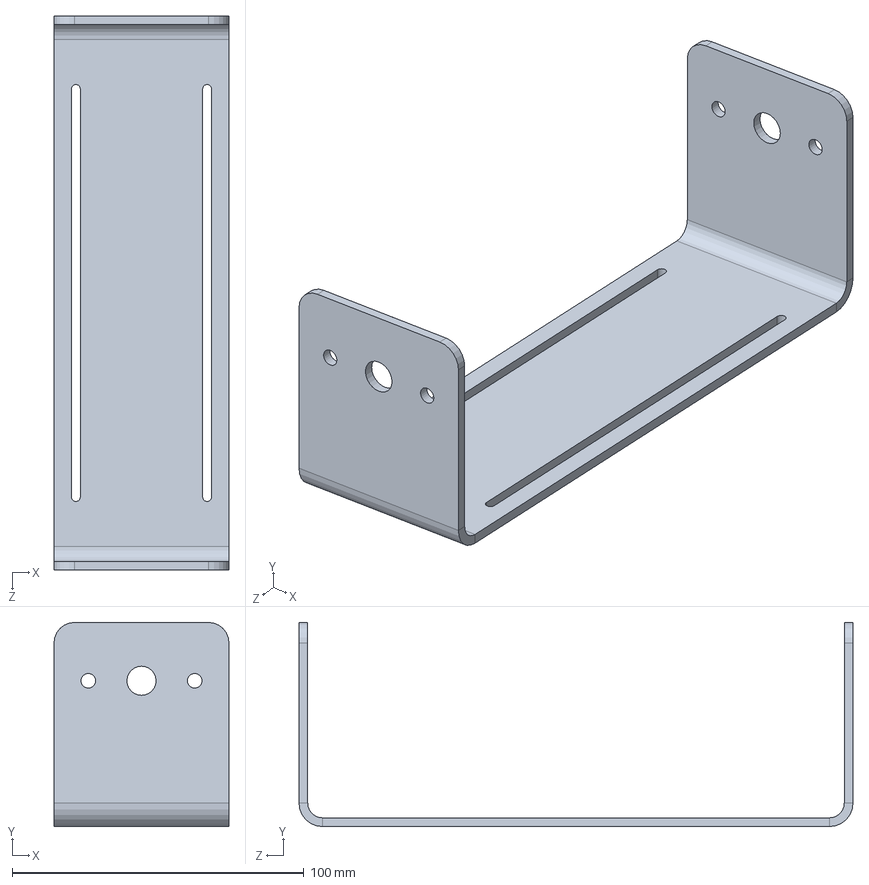
[picture p116: CAD file, 2022-07-14]
5 Axis Extension/C-Axis Base.SLDPRT
60.0 x 70.0 x 190.0 mm
