MohamedHassan-coder/5-Axis-CNC/Chuck/Ring.SLDPRT

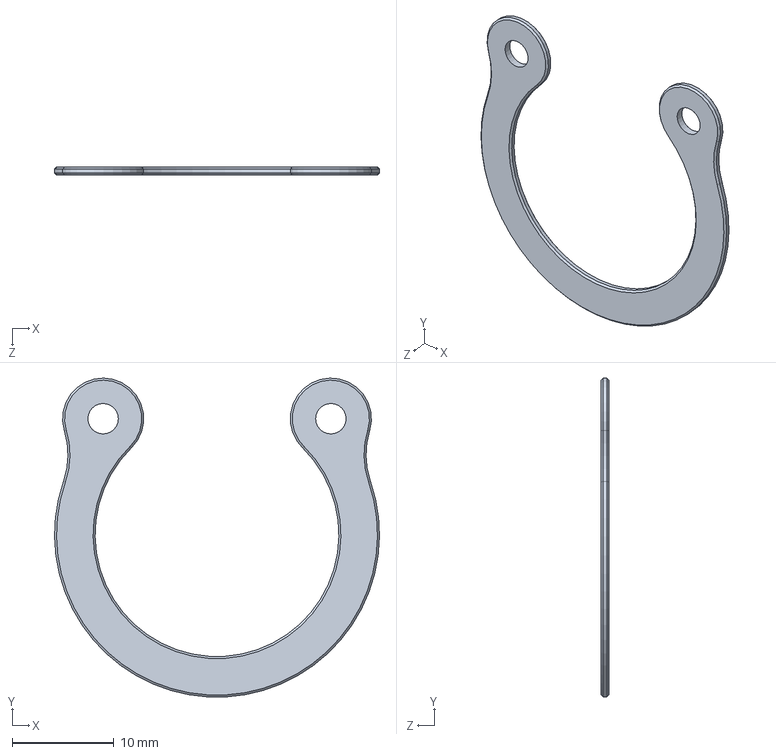
[picture p117: CAD file, 2022-03-01]
Chuck/Ring.SLDPRT
32.0 x 31.4 x 0.8 mm
