MohamedHassan-coder/5-Axis-CNC/Collet & Chuck/ER11 - Collet Chuck.SLDPRT

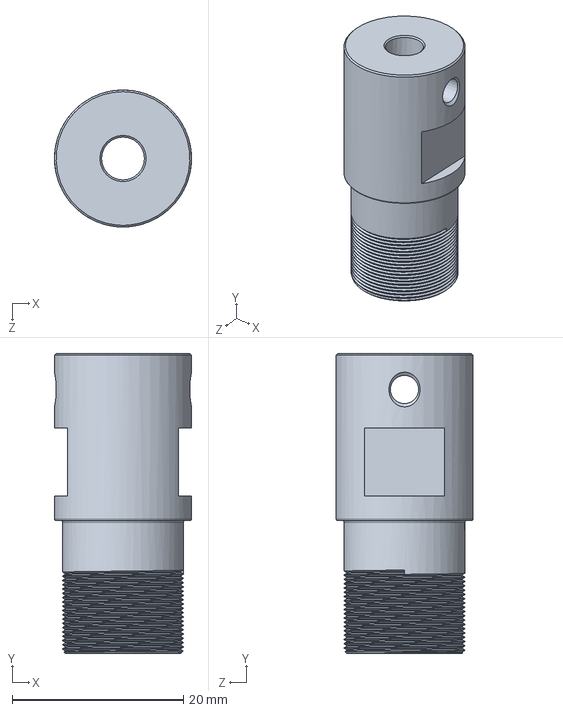
[picture p118: CAD file, 2022-02-12]
Collet & Chuck/ER11 - Collet Chuck.SLDPRT
16.0 x 35.0 x 16.0 mm
