MohamedHassan-coder/5-Axis-CNC/Control Box/Fan_Side.SLDPRT

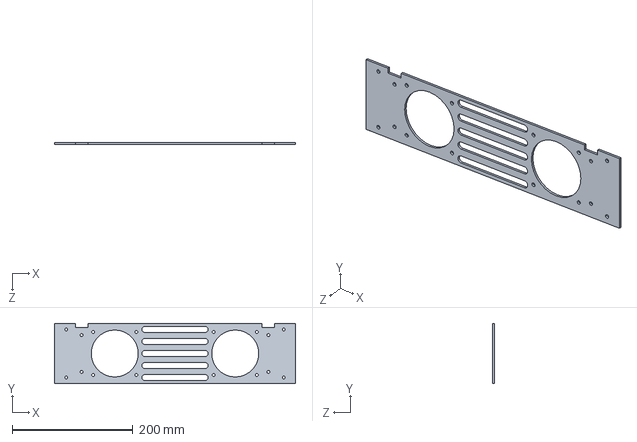
[picture p119: CAD file, 2022-07-14]
Control Box/Fan_Side.SLDPRT
400.0 x 100.0 x 3.00 mm
