MohamedHassan-coder/5-Axis-CNC/Linear_Guide & Rails/Linear Bearing Block QEH20CA.SLDPRT

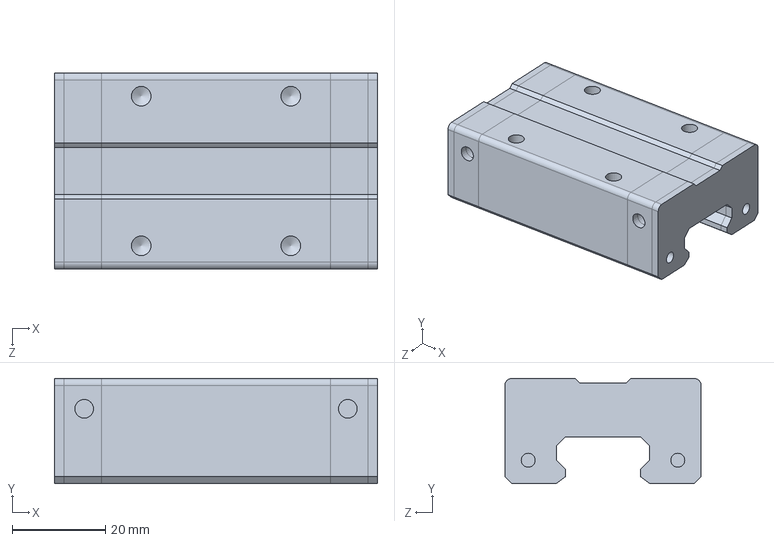
[picture p120: CAD file, 2022-02-13]
Linear_Guide & Rails/Linear Bearing Block QEH20CA.SLDPRT
69.1 x 22.5 x 42.0 mm
