MohamedHassan-coder/5-Axis-CNC/Motors/Nema 17/Bottom Body.SLDPRT

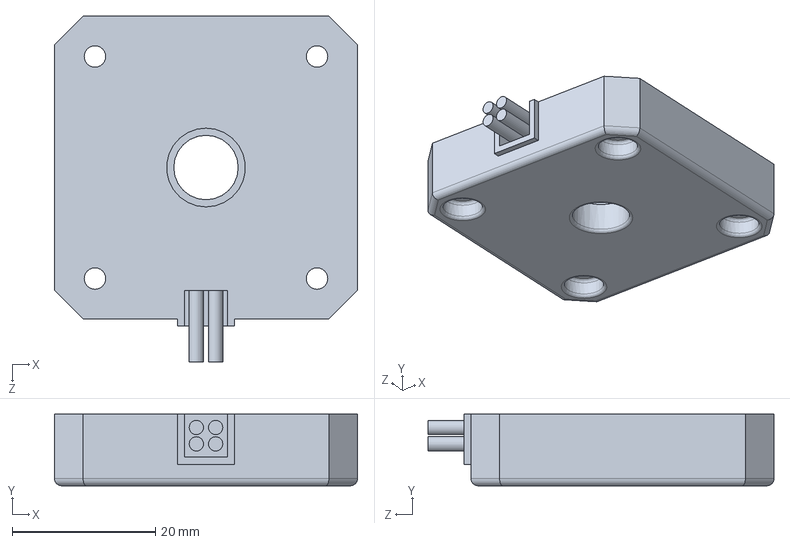
[picture p122: CAD file, 2022-02-13]
Motors/Nema 17/Bottom Body.SLDPRT
42.3 x 10.0 x 48.3 mm
