MohamedHassan-coder/5-Axis-CNC/Other Parts/2020 Fixation.SLDPRT

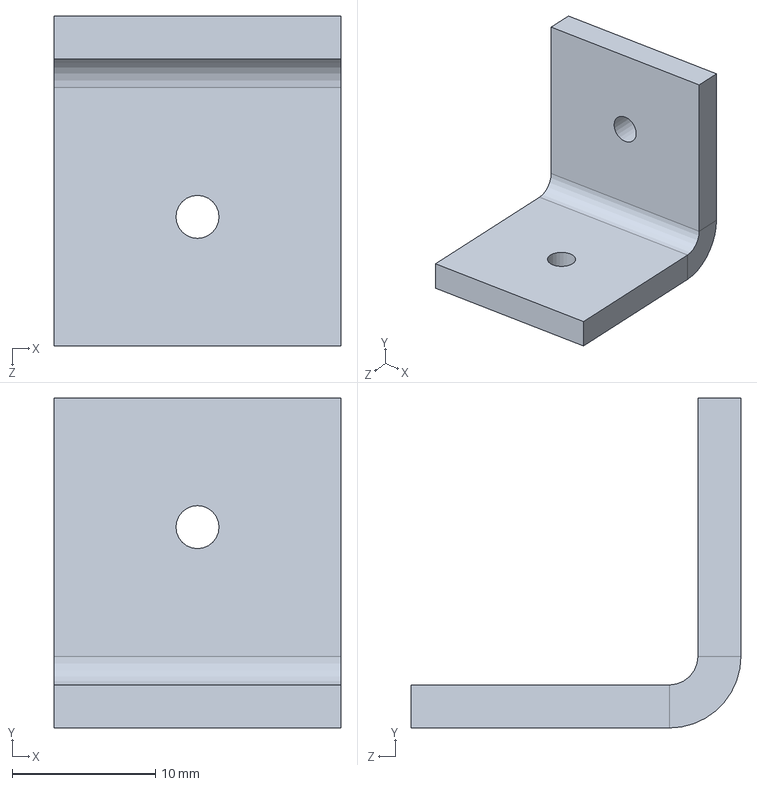
[picture p123: CAD file, 2022-07-14]
Other Parts/2020 Fixation.SLDPRT
20.0 x 23.0 x 23.0 mm
