MohamedHassan-coder/5-Axis-CNC/5 Axis Extension/GT2 36T id 5mm bw 6mm.SLDPRT

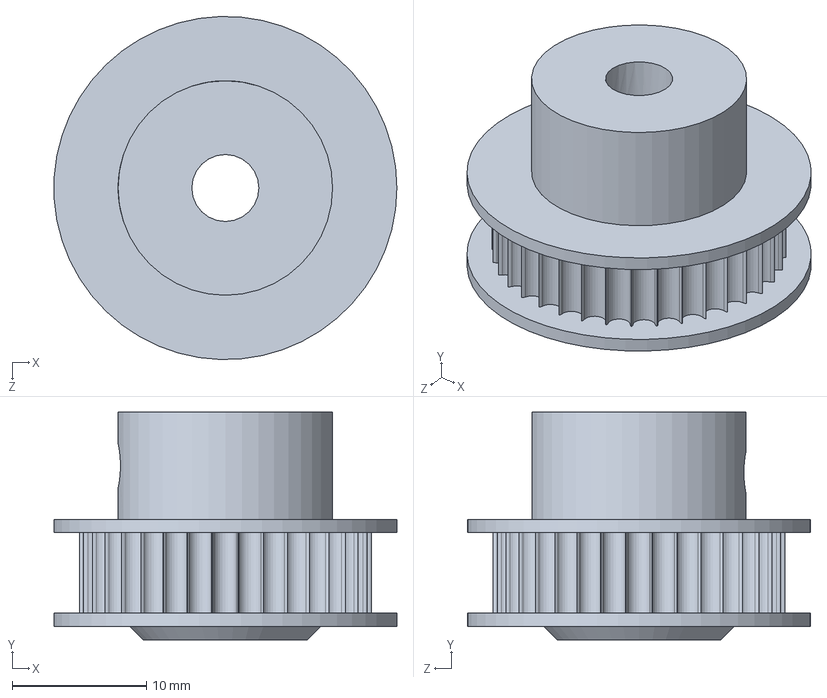
[picture p124: CAD file, 2022-03-04]
5 Axis Extension/GT2 36T id 5mm bw 6mm.SLDPRT
25.6 x 17.0 x 25.6 mm
