MohamedHassan-coder/5-Axis-CNC/Chuck/Scroll_Plate.SLDPRT

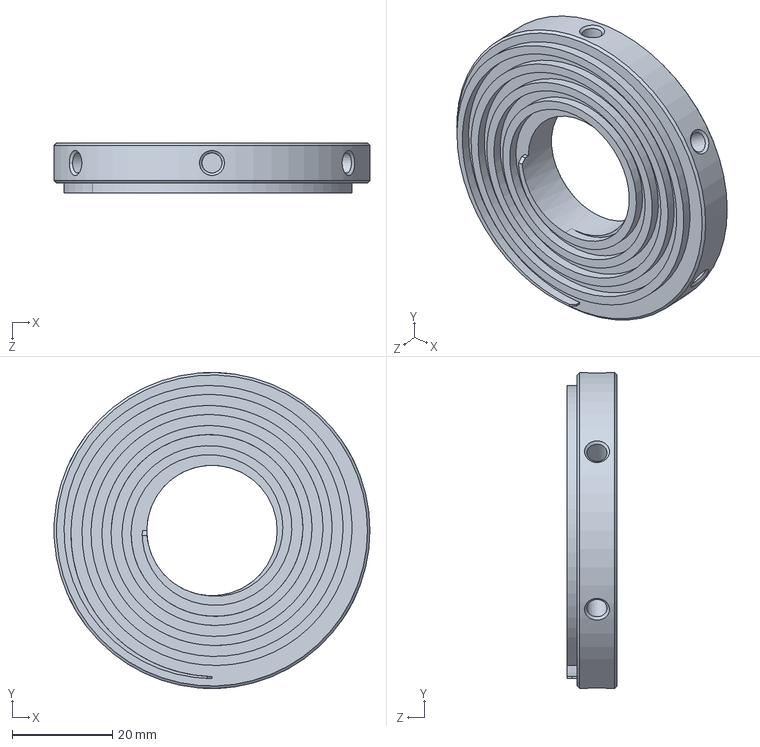
[picture p125: CAD file, 2022-03-01]
Chuck/Scroll_Plate.SLDPRT
63.0 x 63.0 x 10.0 mm
