MohamedHassan-coder/5-Axis-CNC/Control Box/Base.SLDPRT

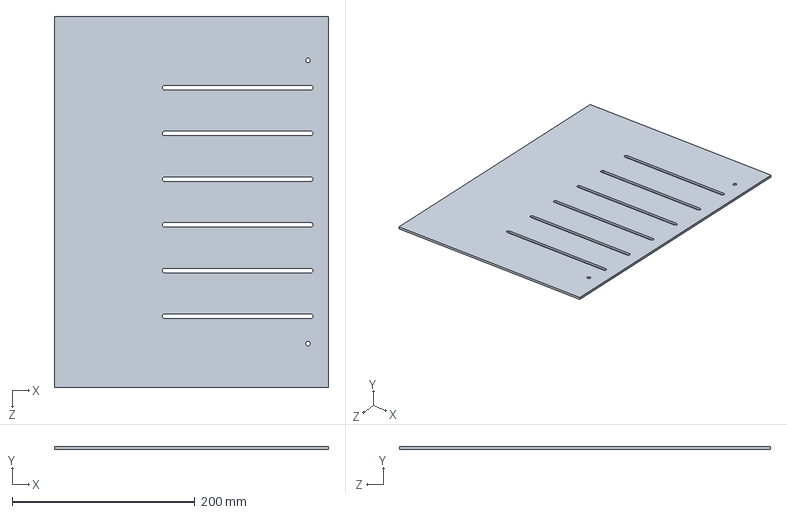
[picture p126: CAD file, 2022-07-14]
Control Box/Base.SLDPRT
300.0 x 3.00 x 406.0 mm
