MohamedHassan-coder/5-Axis-CNC/Main Frame/Y_Bearing_Side.SLDPRT

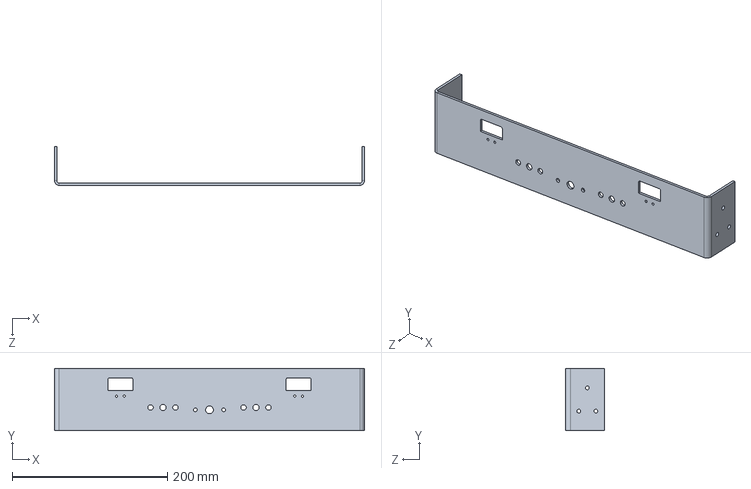
[picture p127: CAD file, 2022-07-14]
Main Frame/Y_Bearing_Side.SLDPRT
400.0 x 80.0 x 50.0 mm
