MohamedHassan-coder/5-Axis-CNC/Motors/Nema 17/Stepper Ass.SLDPRT

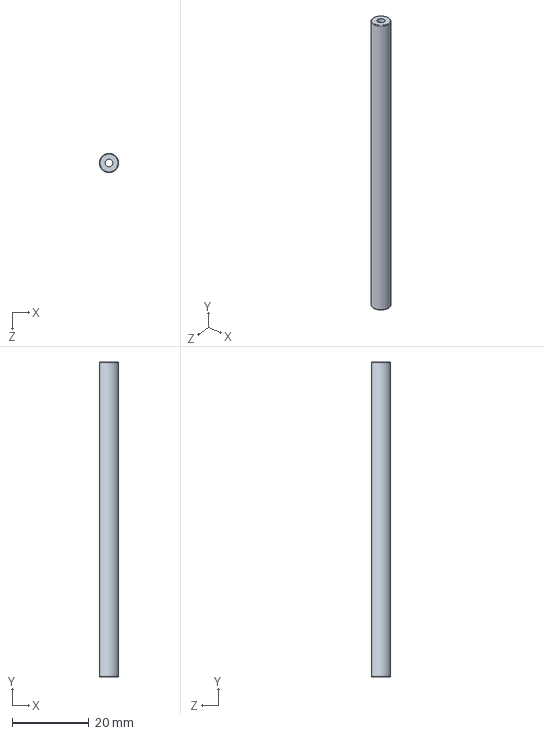
[picture p128: CAD file, 2022-02-13]
Motors/Nema 17/Stepper Ass.SLDPRT
5.00 x 82.0 x 5.00 mm
