MohamedHassan-coder/5-Axis-CNC/5 Axis Extension/GT2_20T-sh8.SLDPRT

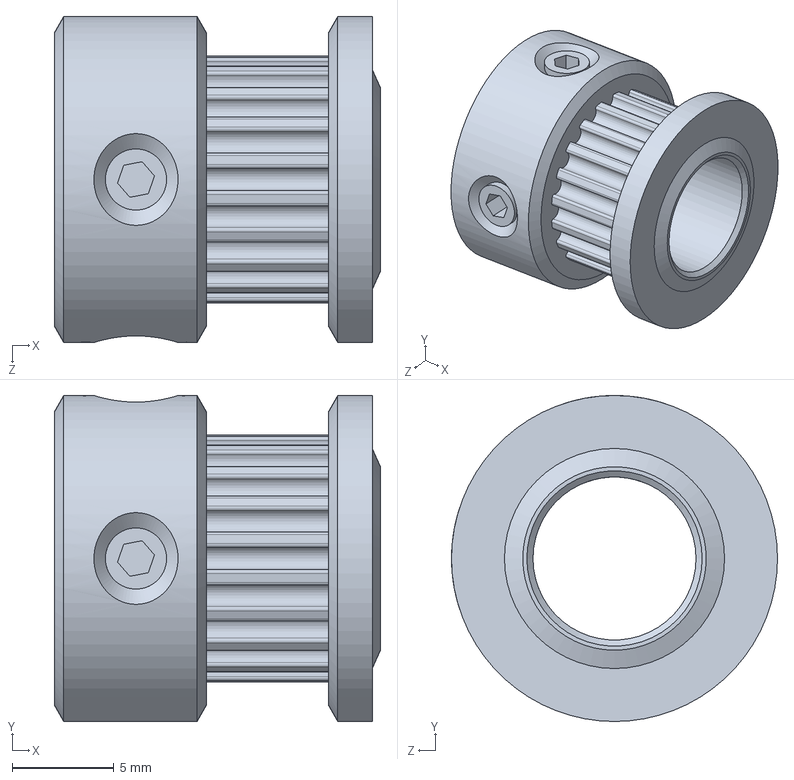
[picture p129: CAD file, 2022-03-03]
5 Axis Extension/GT2_20T-sh8.SLDPRT
16.0 x 16.0 x 16.0 mm
