MohamedHassan-coder/5-Axis-CNC/Chuck/JAW_B.SLDPRT

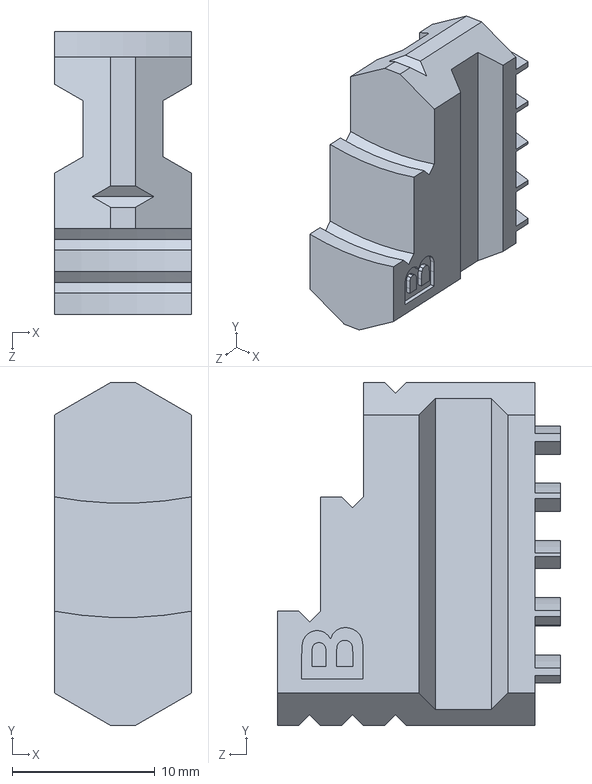
[picture p130: CAD file, 2022-03-01]
Chuck/JAW_B.SLDPRT
9.60 x 24.0 x 19.8 mm
