MohamedHassan-coder/5-Axis-CNC/Control Box/Cover.SLDPRT

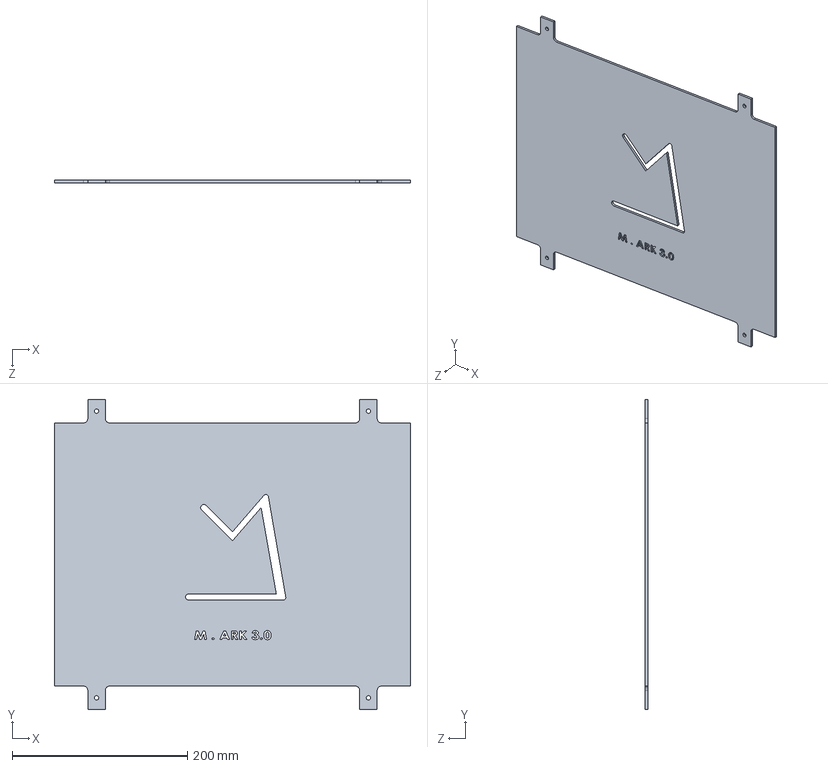
[picture p131: CAD file, 2022-07-14]
Control Box/Cover.SLDPRT
406.0 x 354.0 x 3.00 mm
