MohamedHassan-coder/5-Axis-CNC/Main Frame/Door.SLDPRT

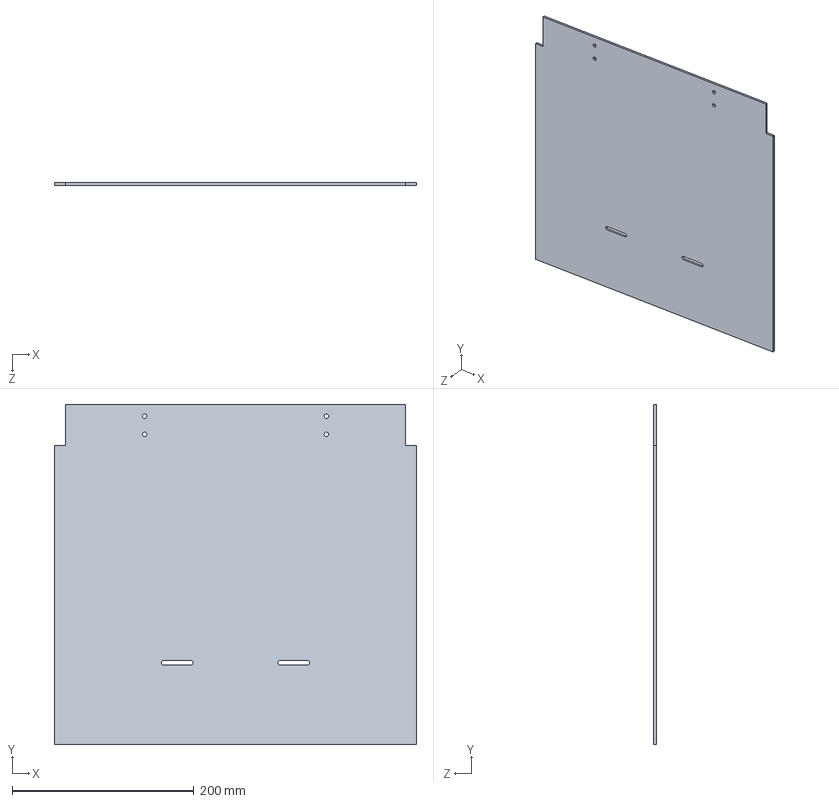
[picture p132: CAD file, 2022-07-14]
Main Frame/Door.SLDPRT
398.0 x 374.0 x 3.00 mm
