MohamedHassan-coder/5-Axis-CNC/Other Parts/Limit Switch Support .SLDPRT

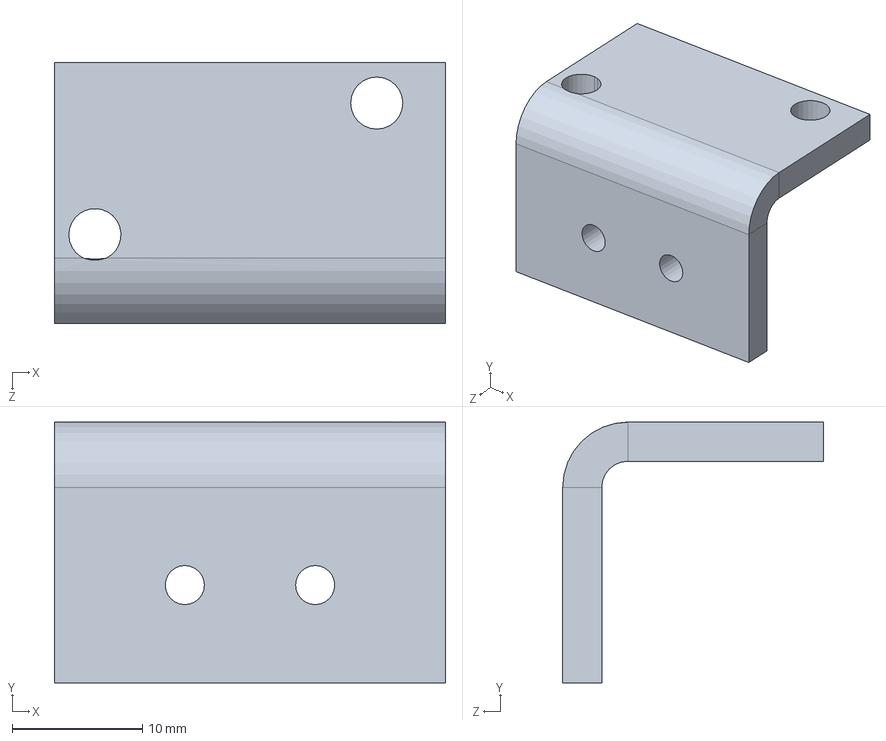
[picture p133: CAD file, 2022-07-14]
Other Parts/Limit Switch Support .SLDPRT
30.0 x 20.0 x 20.0 mm
