MohamedHassan-coder/5-Axis-CNC/Control Box/Fixation_2_M-C.SLDPRT

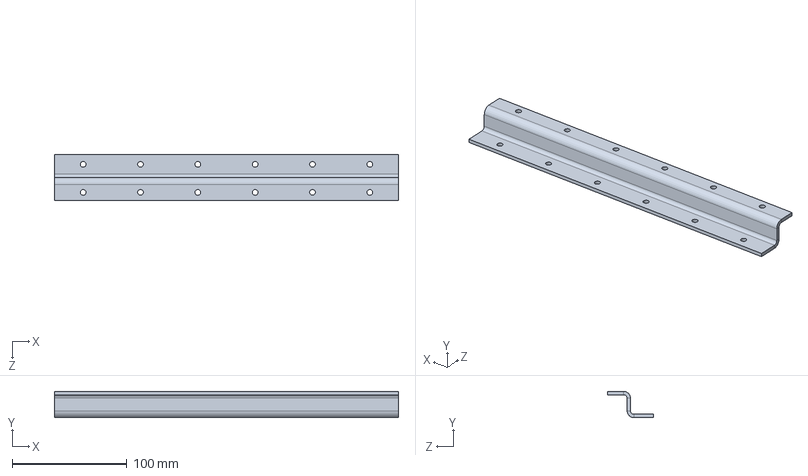
[picture p135: CAD file, 2022-07-14]
Control Box/Fixation_2_M-C.SLDPRT
300.0 x 23.0 x 40.0 mm
