MohamedHassan-coder/5-Axis-CNC/Main Frame/Back_Panel_Support.SLDPRT

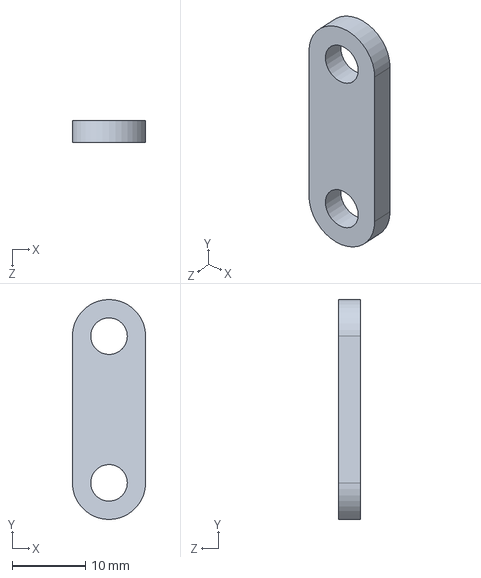
[picture p136: CAD file, 2022-07-14]
Main Frame/Back_Panel_Support.SLDPRT
10.0 x 30.0 x 3.00 mm
