MohamedHassan-coder/5-Axis-CNC/Other Parts/Knob.SLDPRT

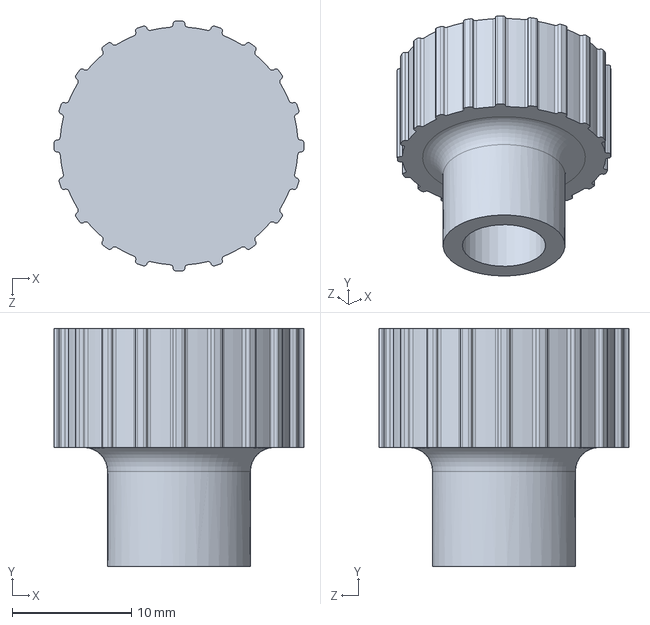
[picture p137: CAD file, 2022-07-14]
Other Parts/Knob.SLDPRT
21.0 x 20.0 x 21.0 mm
