MohamedHassan-coder/5-Axis-CNC/5 Axis Extension/C-Axis Rotate Part.SLDPRT

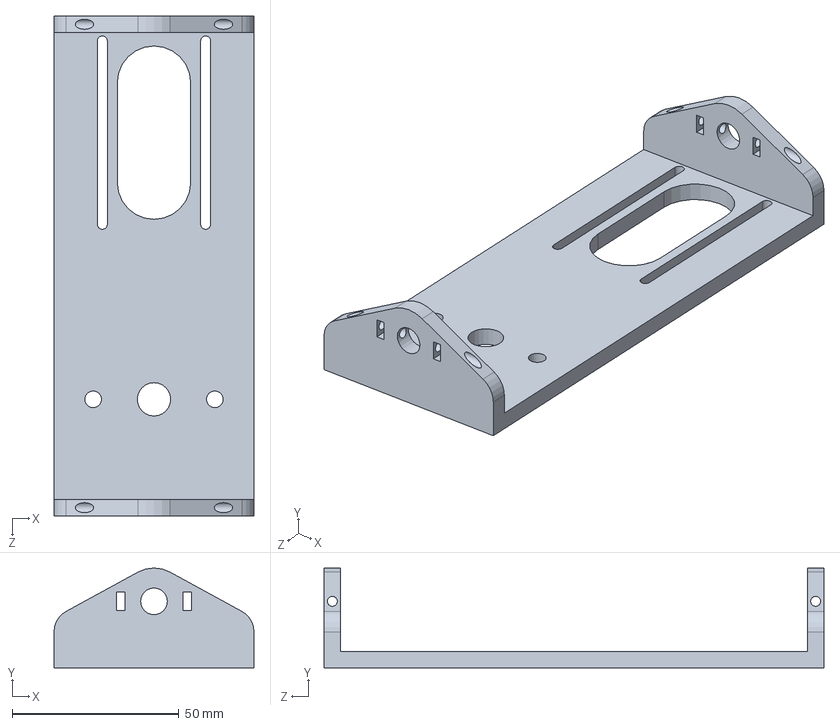
[picture p138: CAD file, 2022-03-03]
5 Axis Extension/C-Axis Rotate Part.SLDPRT
60.0 x 30.0 x 150.0 mm
