MohamedHassan-coder/5-Axis-CNC/Control Box/Sheet_Metal Version.SLDPRT

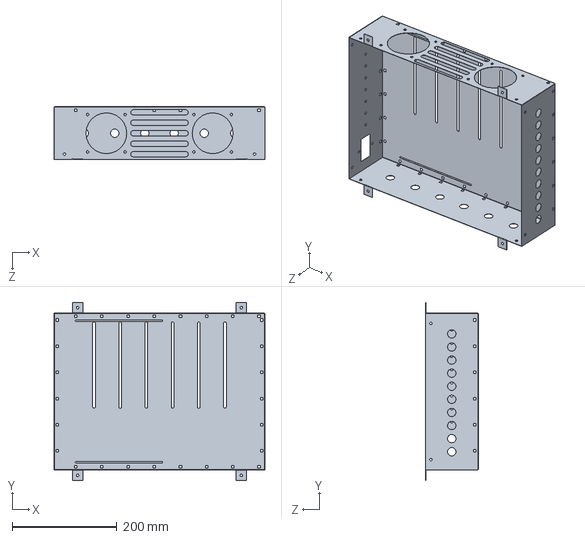
[picture p139: CAD file, 2022-07-14]
Control Box/Sheet_Metal Version.SLDPRT
403.0 x 340.0 x 100.5 mm
