MohamedHassan-coder/5-Axis-CNC/Main Frame/X_Stepper_Side.SLDPRT

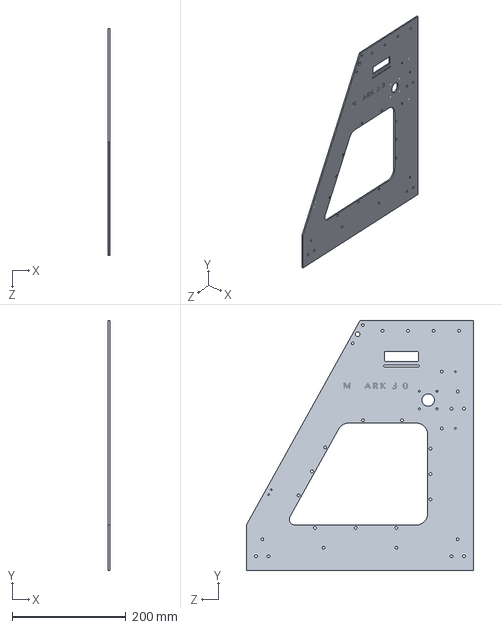
[picture p140: CAD file, 2022-07-14]
Main Frame/X_Stepper_Side.SLDPRT
3.00 x 440.0 x 400.0 mm
