MohamedHassan-coder/5-Axis-CNC/Other Parts/WP_Fixation.SLDPRT

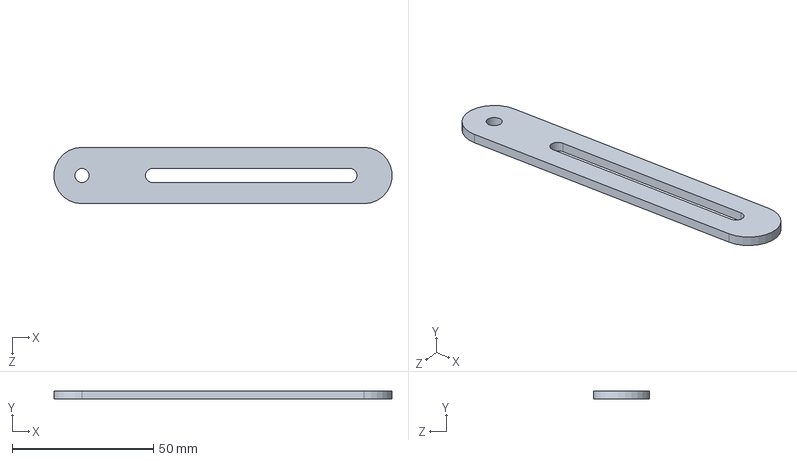
[picture p141: CAD file, 2022-07-14]
Other Parts/WP_Fixation.SLDPRT
119.9 x 3.00 x 20.0 mm
