MohamedHassan-coder/5-Axis-CNC/5 Axis Extension/C-Axis Rod2.SLDPRT

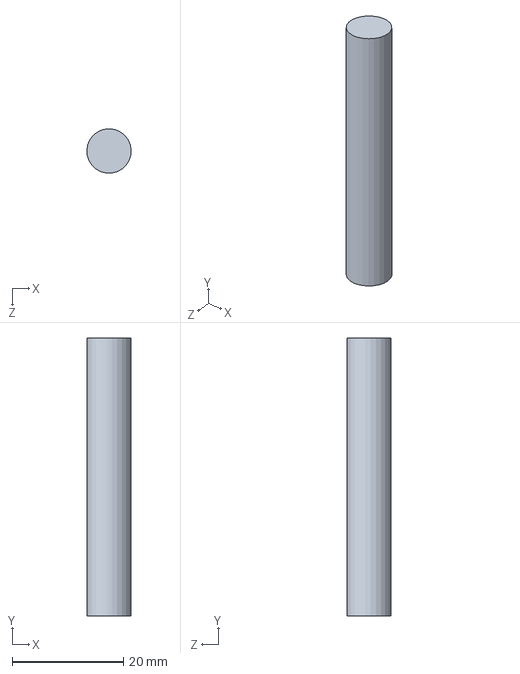
[picture p142: CAD file, 2022-03-03]
5 Axis Extension/C-Axis Rod2.SLDPRT
7.98 x 50.0 x 8.00 mm
