MohamedHassan-coder/5-Axis-CNC/Control Box/Cotrolle_Face.SLDPRT

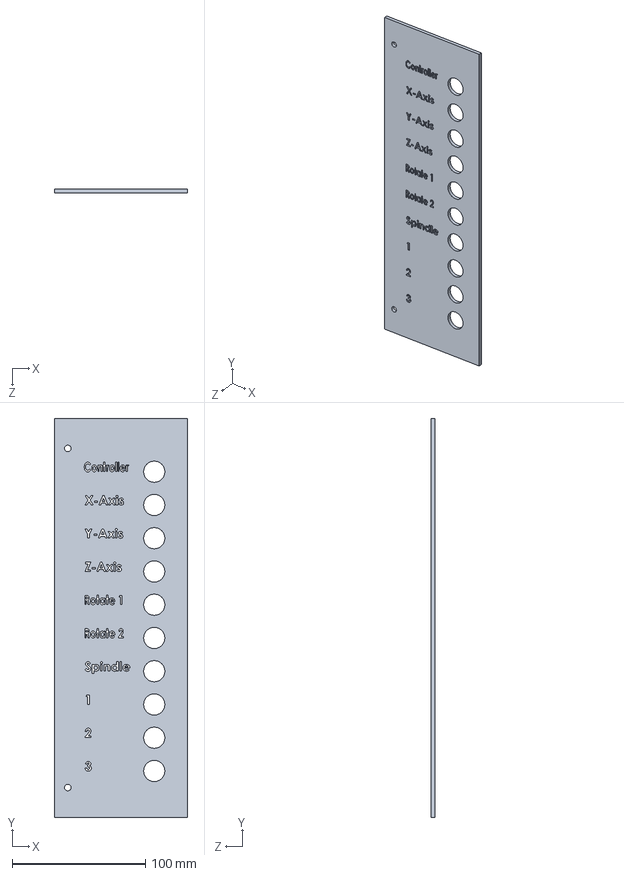
[picture p143: CAD file, 2022-07-14]
Control Box/Cotrolle_Face.SLDPRT
100.0 x 300.0 x 3.00 mm
