MohamedHassan-coder/5-Axis-CNC/Other Parts/WP.SLDPRT

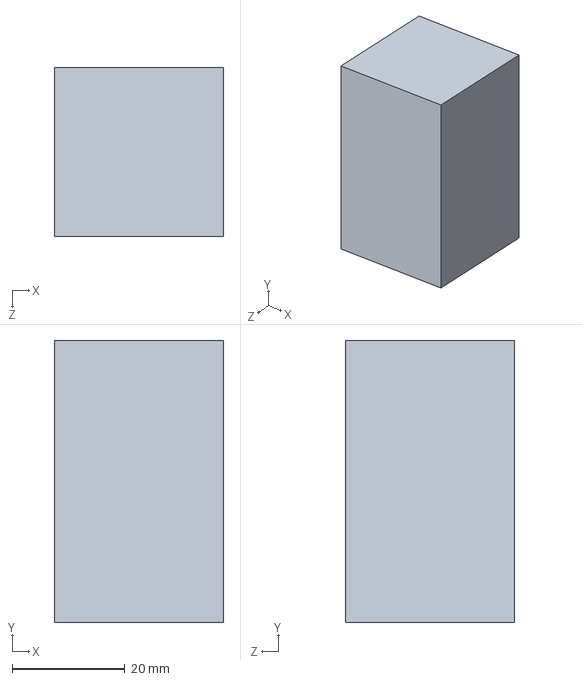
[picture p144: CAD file, 2022-03-02]
Other Parts/WP.SLDPRT
30.0 x 50.0 x 30.0 mm
