MohamedHassan-coder/5-Axis-CNC/5 Axis Extension/C-Axis Rod1.SLDPRT

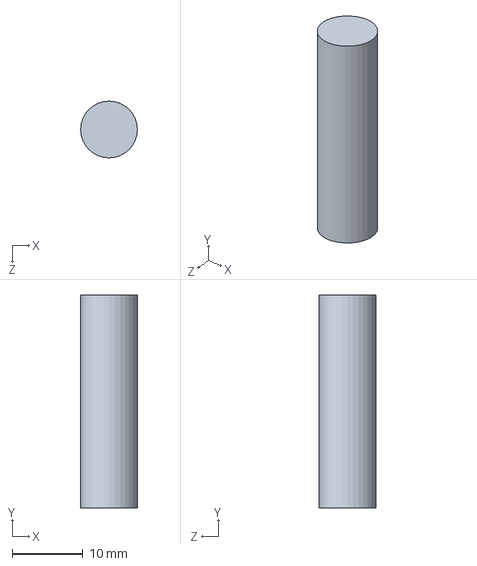
[picture p145: CAD file, 2022-03-01]
5 Axis Extension/C-Axis Rod1.SLDPRT
8.00 x 30.0 x 8.00 mm
