MohamedHassan-coder/5-Axis-CNC/Main Frame/Spindle_Base.SLDPRT

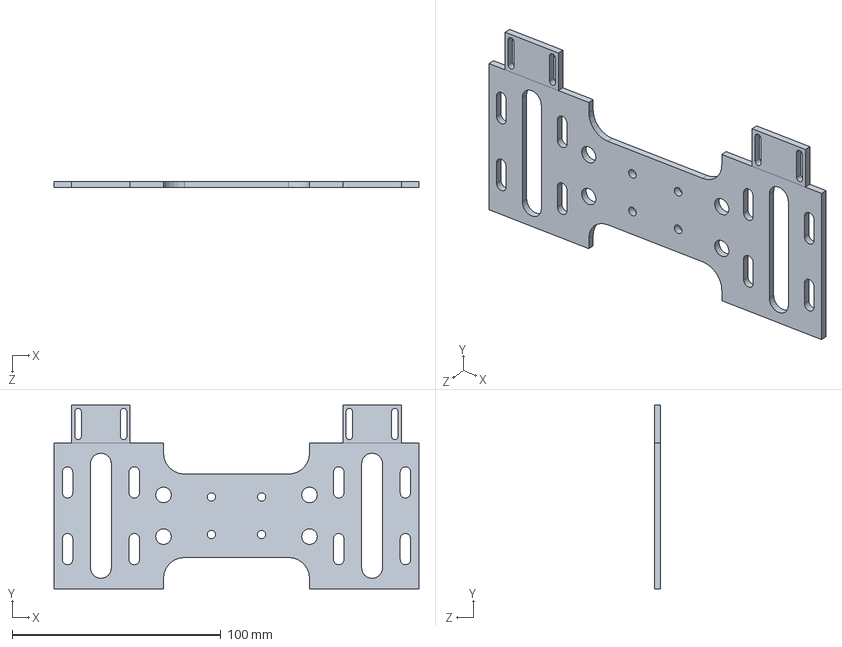
[picture p146: CAD file, 2022-07-14]
Main Frame/Spindle_Base.SLDPRT
175.0 x 88.0 x 3.00 mm
