MohamedHassan-coder/5-Axis-CNC/Other Parts/Switch SV-166-1C25.STEP

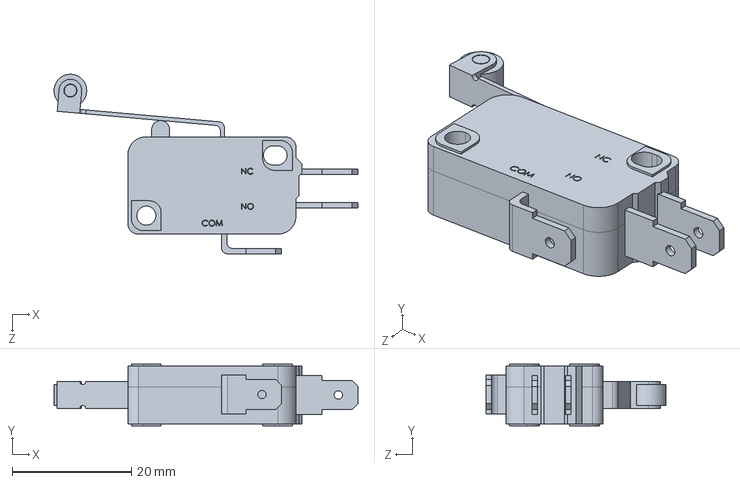
[picture p147: CAD file, 2022-02-24]
Other Parts/Switch SV-166-1C25.STEP
51.0 x 10.4 x 30.1 mm
