MohamedHassan-coder/5-Axis-CNC/5 Axis Extension/GT2 60T id 8mm bw 6mm.SLDPRT

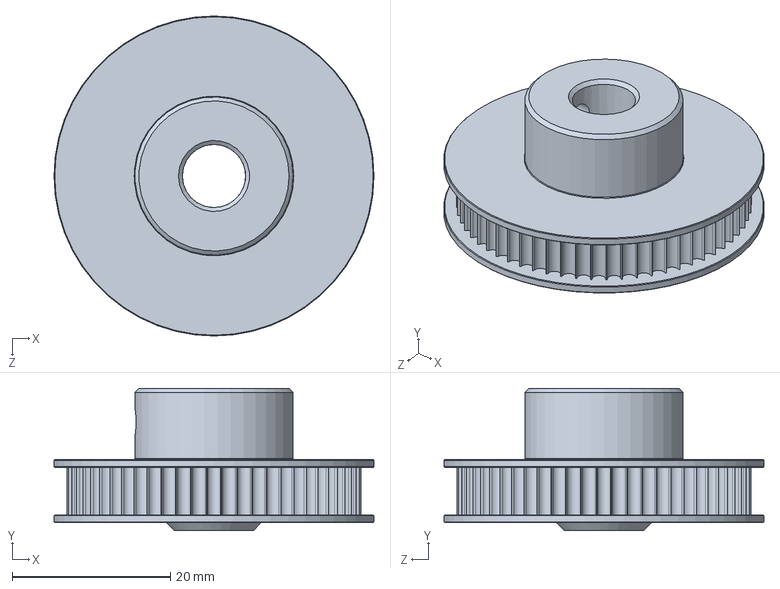
[picture p148: CAD file, 2022-03-01]
5 Axis Extension/GT2 60T id 8mm bw 6mm.SLDPRT
40.5 x 18.0 x 40.5 mm
