MohamedHassan-coder/5-Axis-CNC/Control Box/GX16-8.SLDPRT

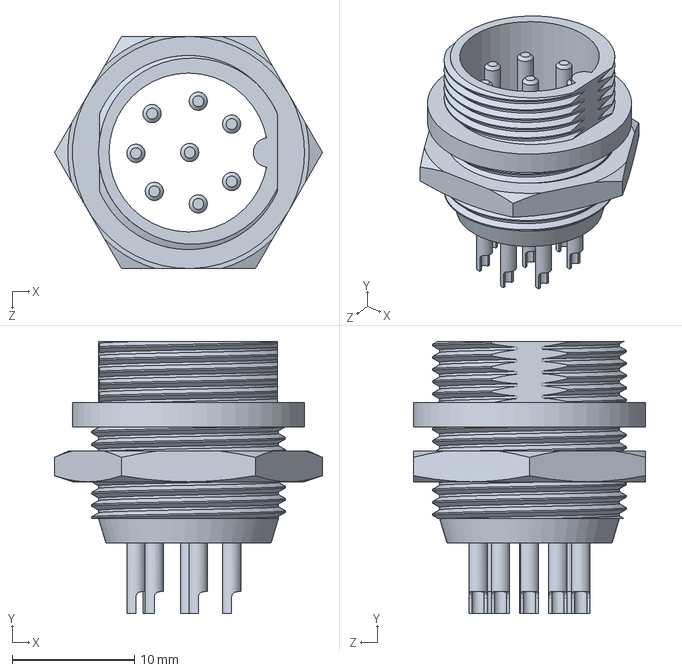
[picture p149: CAD file, 2022-03-04]
Control Box/GX16-8.SLDPRT
21.9 x 22.3 x 19.0 mm
