MohamedHassan-coder/5-Axis-CNC/Main Frame/Back_Support_Top.SLDPRT

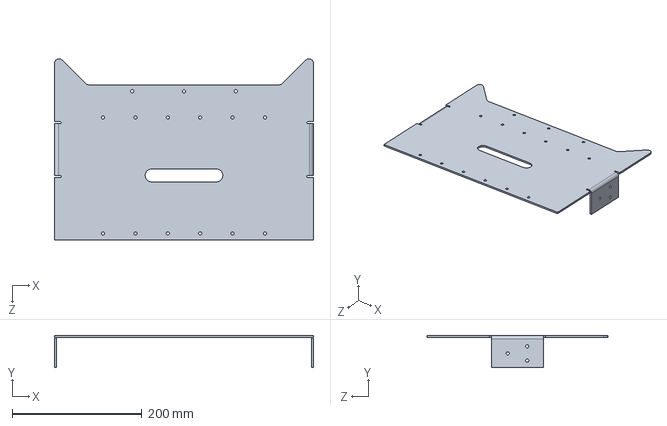
[picture p150: CAD file, 2022-07-14]
Main Frame/Back_Support_Top.SLDPRT
400.0 x 50.0 x 280.1 mm
