MohamedHassan-coder/5-Axis-CNC/Other Parts/B18.3.1M - 5 x 0.8 x 16 Hex SHCS -- 16SHX.sldprt

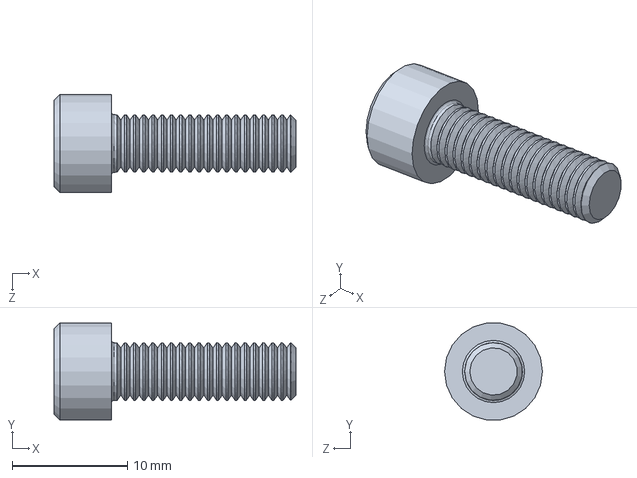
[picture p151: CAD file, 2022-02-22]
Other Parts/B18.3.1M - 5 x 0.8 x 16 Hex SHCS -- 16SHX.sldprt
21.0 x 8.41 x 8.50 mm
