MohamedHassan-coder/5-Axis-CNC/Main Frame/Z_Stepper_Side.SLDPRT

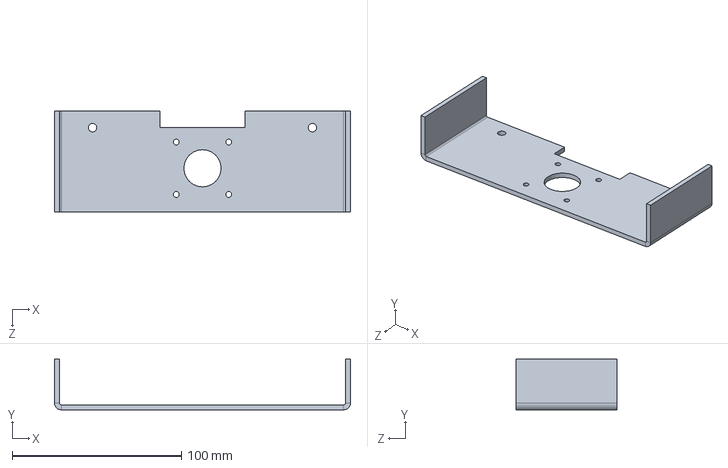
[picture p153: CAD file, 2022-07-14]
Main Frame/Z_Stepper_Side.SLDPRT
175.0 x 30.0 x 60.0 mm
