MohamedHassan-coder/5-Axis-CNC/Other Parts/B18.3.1M - 5 x 0.8 x 30 Hex SHCS -- 30SHX.sldprt

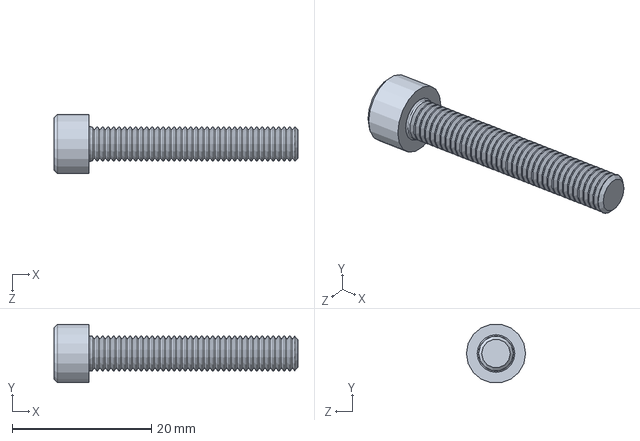
[picture p154: CAD file, 2022-02-22]
Other Parts/B18.3.1M - 5 x 0.8 x 30 Hex SHCS -- 30SHX.sldprt
35.0 x 8.37 x 8.50 mm
