MohamedHassan-coder/5-Axis-CNC/Control Box/GX-16 Connector 2 Pins.SLDPRT

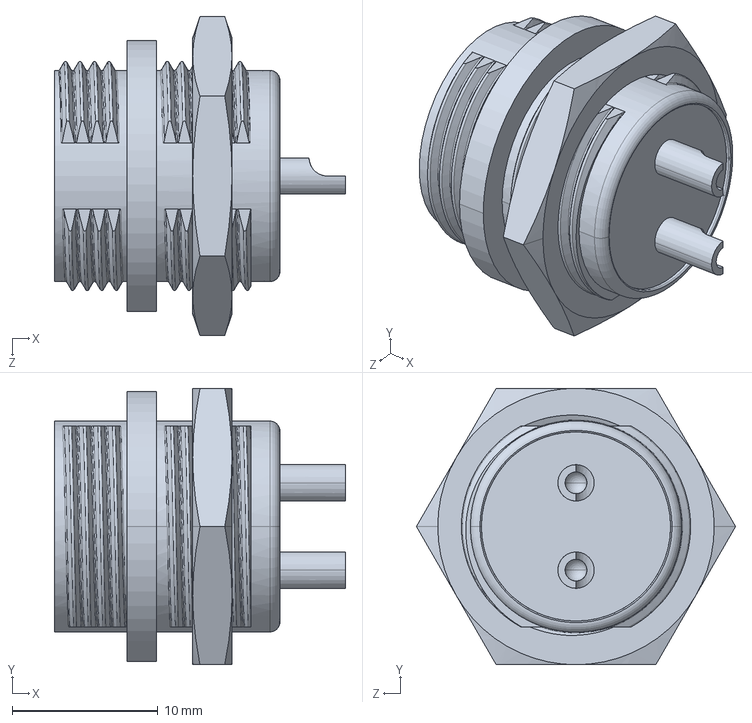
[picture p155: CAD file, 2022-03-04]
Control Box/GX-16 Connector 2 Pins.SLDPRT
20.0 x 19.0 x 21.9 mm
