MohamedHassan-coder/5-Axis-CNC/Main Frame/Back_Panel.SLDPRT

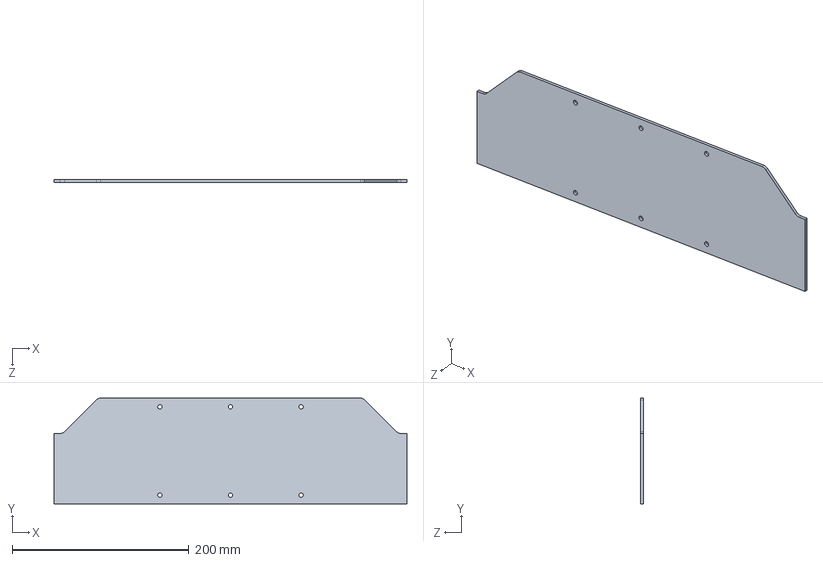
[picture p156: CAD file, 2022-07-14]
Main Frame/Back_Panel.SLDPRT
400.0 x 120.0 x 3.00 mm
