MohamedHassan-coder/5-Axis-CNC/Other Parts/B18.2.4.1M - Hex nut, Style 1,  M5 x 0.8 --D-S.sldprt

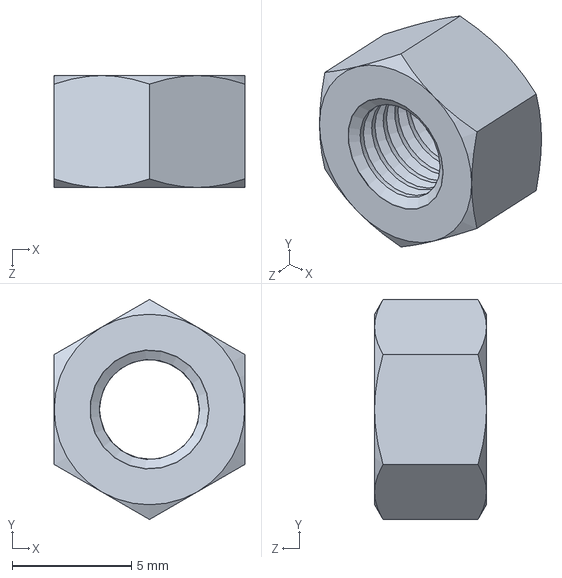
[picture p157: CAD file, 2022-02-22]
Other Parts/B18.2.4.1M - Hex nut, Style 1, M5 x 0.8 --D-S.sldprt
8.00 x 9.24 x 4.70 mm
