MohamedHassan-coder/5-Axis-CNC/Control Box/Button Red.SLDPRT

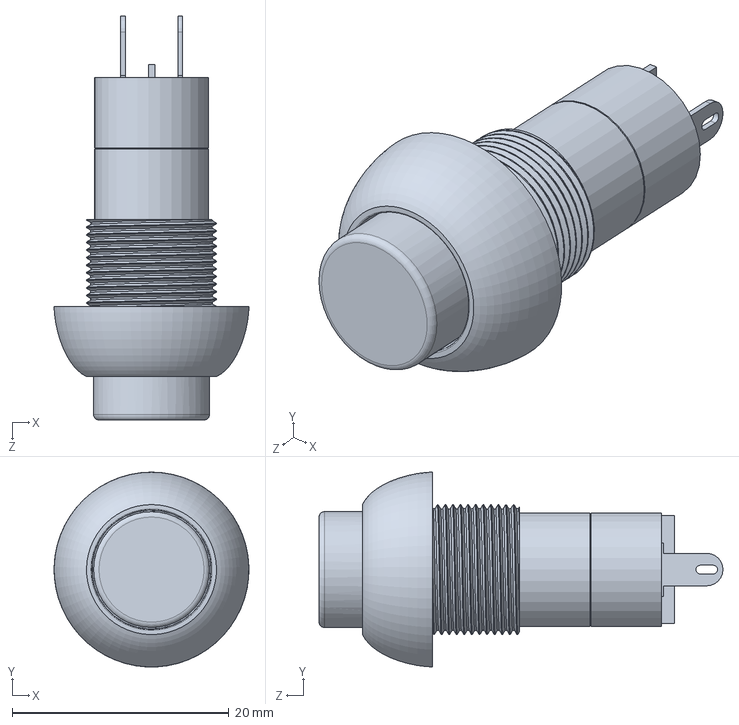
[picture p158: CAD file, 2022-03-04]
Control Box/Button Red.SLDPRT
18.0 x 18.0 x 37.3 mm
