MohamedHassan-coder/5-Axis-CNC/Main Frame/Z_Base.SLDPRT

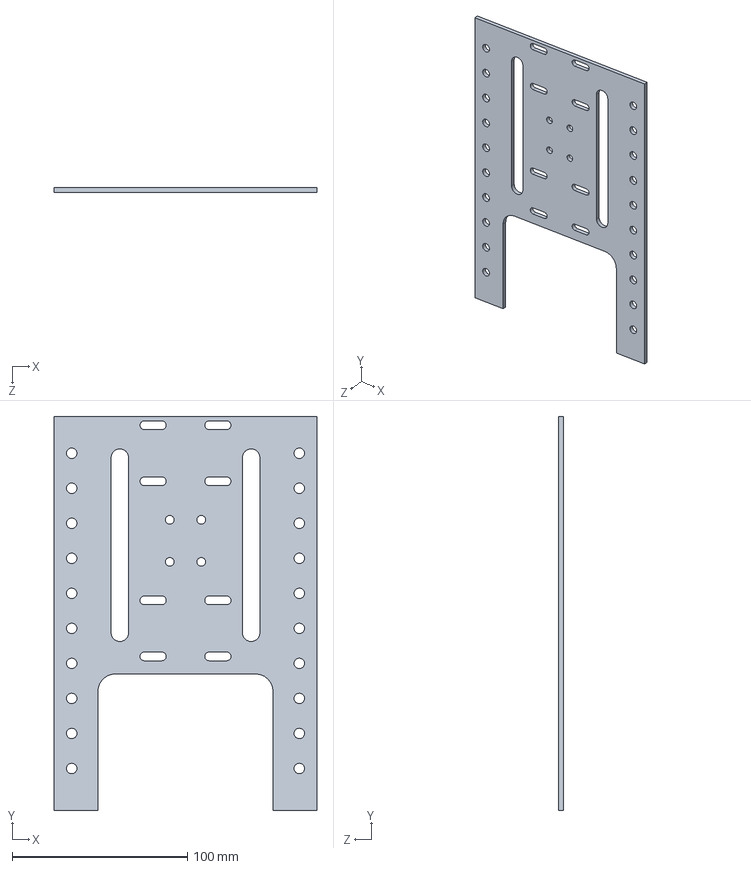
[picture p159: CAD file, 2022-07-14]
Main Frame/Z_Base.SLDPRT
150.0 x 225.0 x 3.00 mm
