MohamedHassan-coder/5-Axis-CNC/Control Box/8412NGLE_EBM-PAPST.SLDPRT

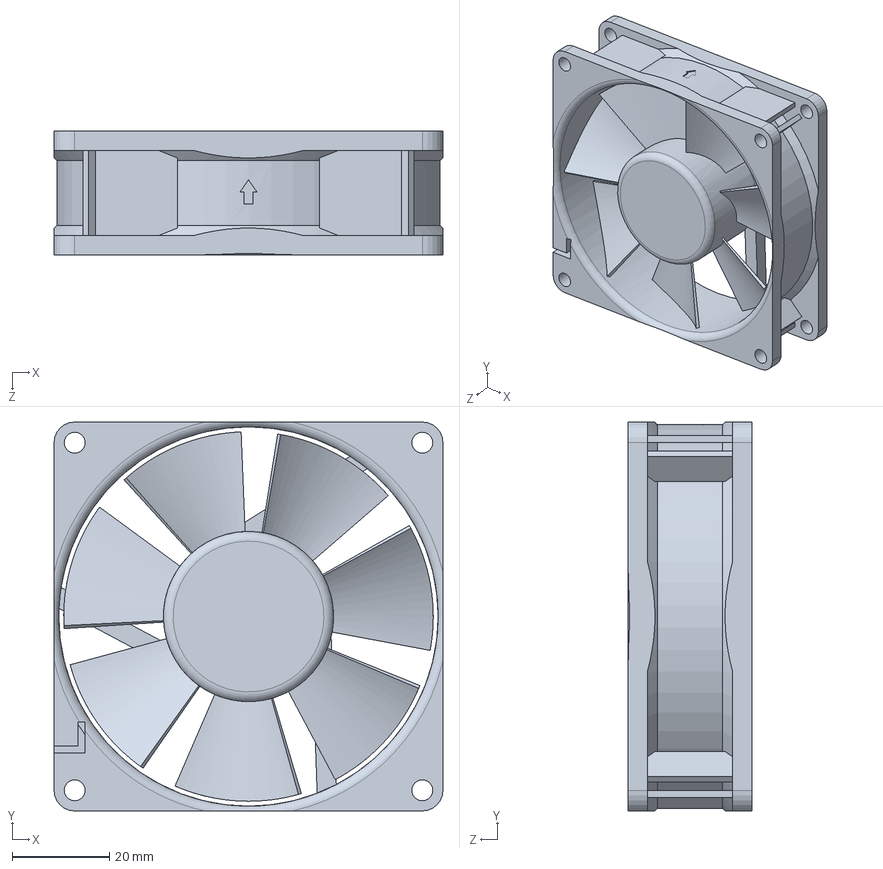
[picture p160: CAD file, 2022-03-04]
Control Box/8412NGLE_EBM-PAPST.SLDPRT
80.0 x 80.0 x 25.4 mm
