MohamedHassan-coder/5-Axis-CNC/Main Frame/Handle.SLDPRT

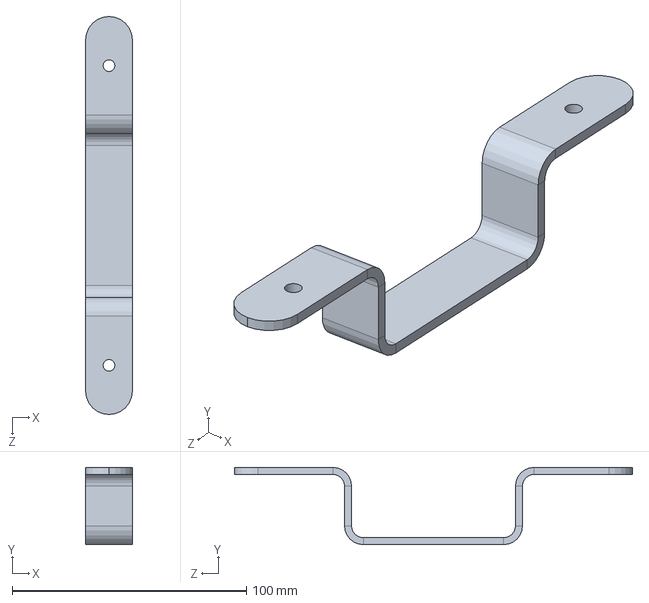
[picture p161: CAD file, 2022-07-14]
Main Frame/Handle.SLDPRT
20.0 x 33.0 x 170.0 mm
