MohamedHassan-coder/5-Axis-CNC/Control Box/ArduinoMega.SLDPRT

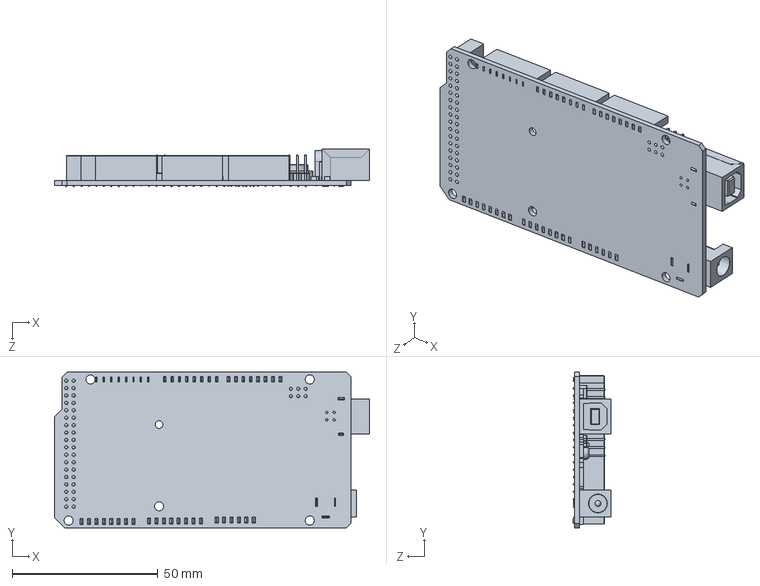
[picture p162: CAD file, 2022-03-04]
Control Box/ArduinoMega.SLDPRT
107.9 x 53.4 x 13.0 mm
