MohamedHassan-coder/5-Axis-CNC/Main Frame/Side_Panel_Vaccum_side_new.SLDPRT

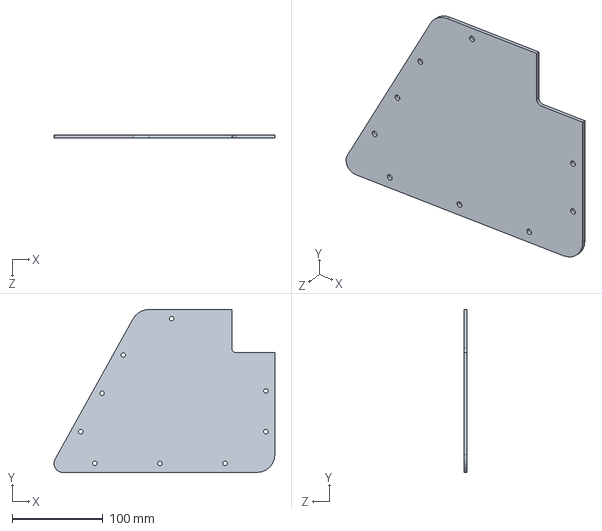
[picture p163: CAD file, 2022-07-14]
Main Frame/Side_Panel_Vaccum_side_new.SLDPRT
243.4 x 179.5 x 3.00 mm
