MohamedHassan-coder/5-Axis-CNC/Control Box/Fused AC Male Power Socket.SLDPRT

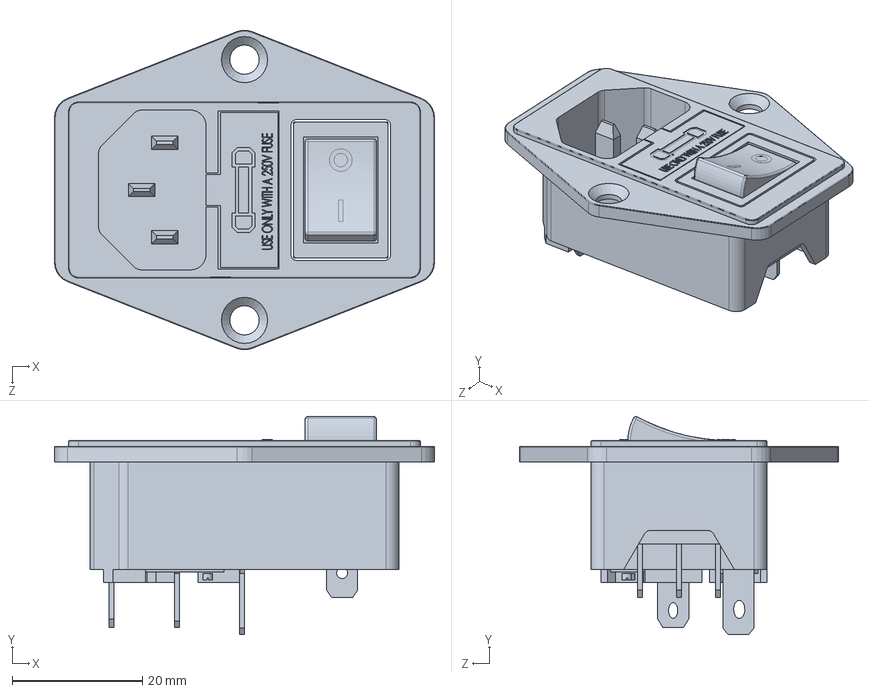
[picture p164: CAD file, 2022-03-04]
Control Box/Fused AC Male Power Socket.SLDPRT
58.3 x 33.4 x 49.0 mm
