MohamedHassan-coder/5-Axis-CNC/Main Frame/Roof_Support.SLDPRT

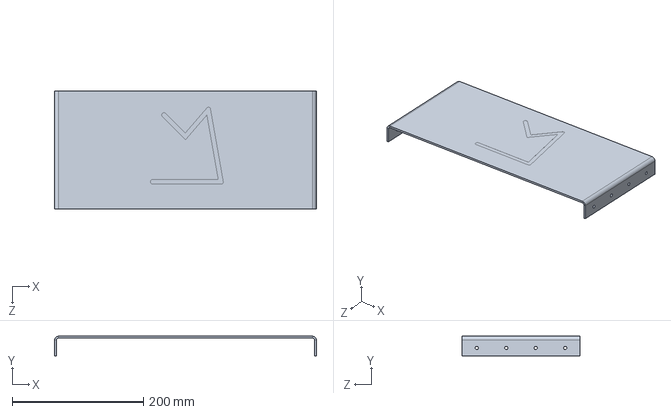
[picture p165: CAD file, 2022-07-14]
Main Frame/Roof_Support.SLDPRT
400.0 x 30.0 x 180.0 mm
