MohamedHassan-coder/5-Axis-CNC/Main Frame/Side_Panel_inside.SLDPRT

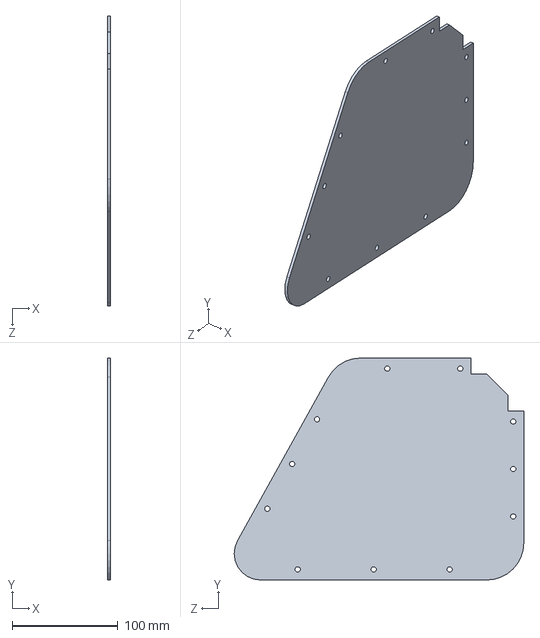
[picture p166: CAD file, 2022-07-14]
Main Frame/Side_Panel_inside.SLDPRT
3.00 x 209.5 x 273.4 mm
