MohamedHassan-coder/5-Axis-CNC/Main Frame/Side_Panel_Support.SLDPRT

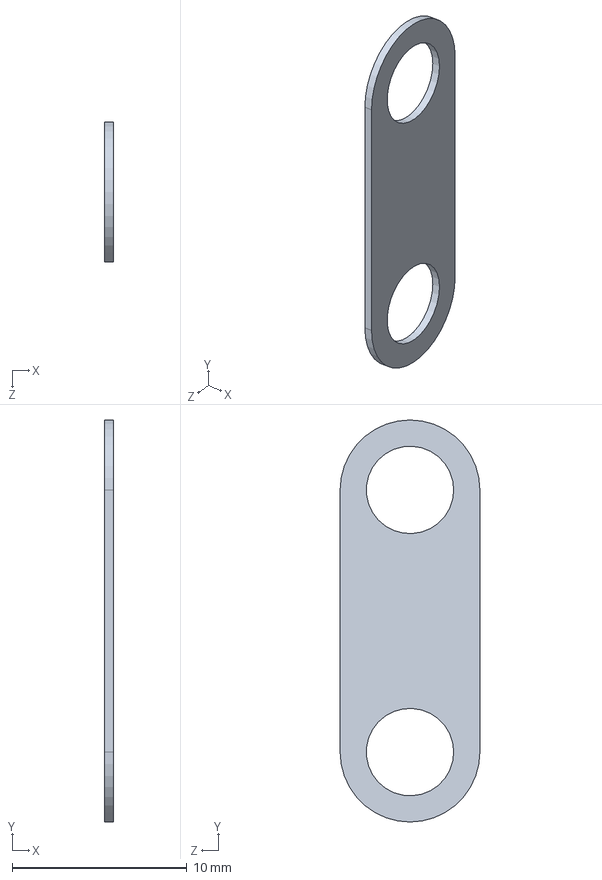
[picture p167: CAD file, 2022-07-14]
Main Frame/Side_Panel_Support.SLDPRT
0.5 x 23.0 x 8.00 mm
