MohamedHassan-coder/5-Axis-CNC/Main Frame/Door_Hinge.SLDPRT

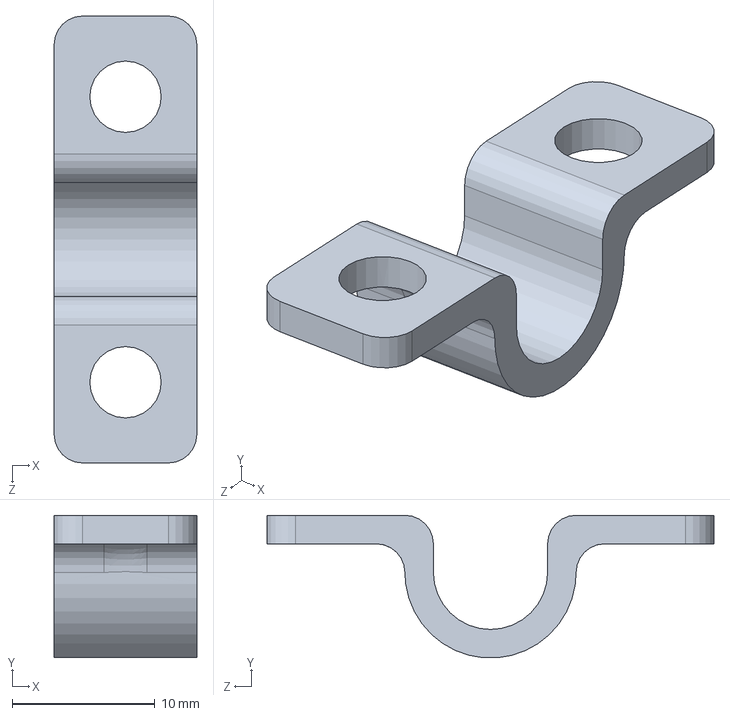
[picture p168: CAD file, 2022-02-28]
Main Frame/Door_Hinge.SLDPRT
10.0 x 9.98 x 31.3 mm
