MohamedHassan-coder/5-Axis-CNC/Main Frame/M8 knob.STEP

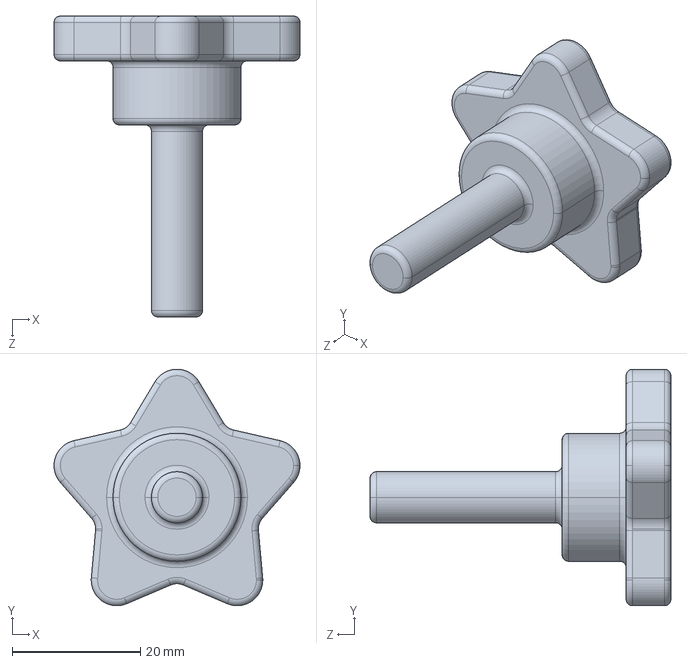
[picture p169: CAD file, 2022-02-28]
Main Frame/M8 knob.STEP
38.4 x 36.9 x 47.0 mm
