MohamedHassan-coder/5-Axis-CNC/Main Frame/Door_Stopper.SLDPRT

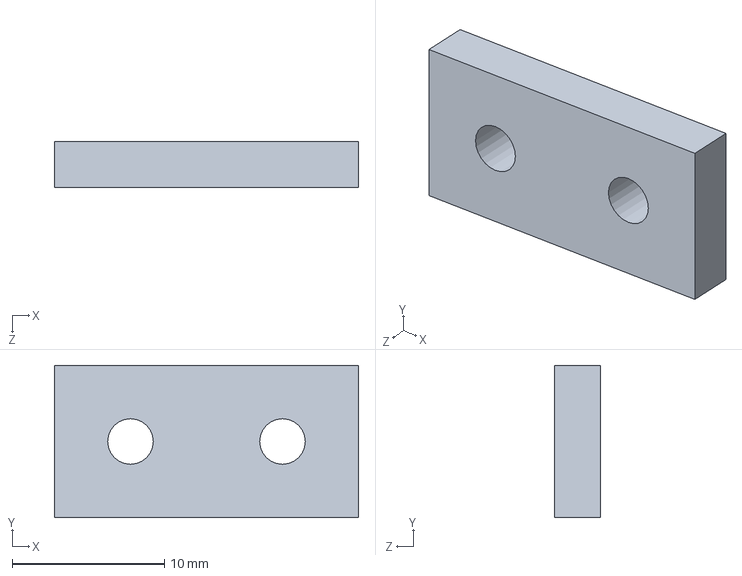
[picture p170: CAD file, 2022-02-27]
Main Frame/Door_Stopper.SLDPRT
20.0 x 10.0 x 3.00 mm
