MohamedHassan-coder/5-Axis-CNC/Main Frame/X_Side_Raw.SLDPRT

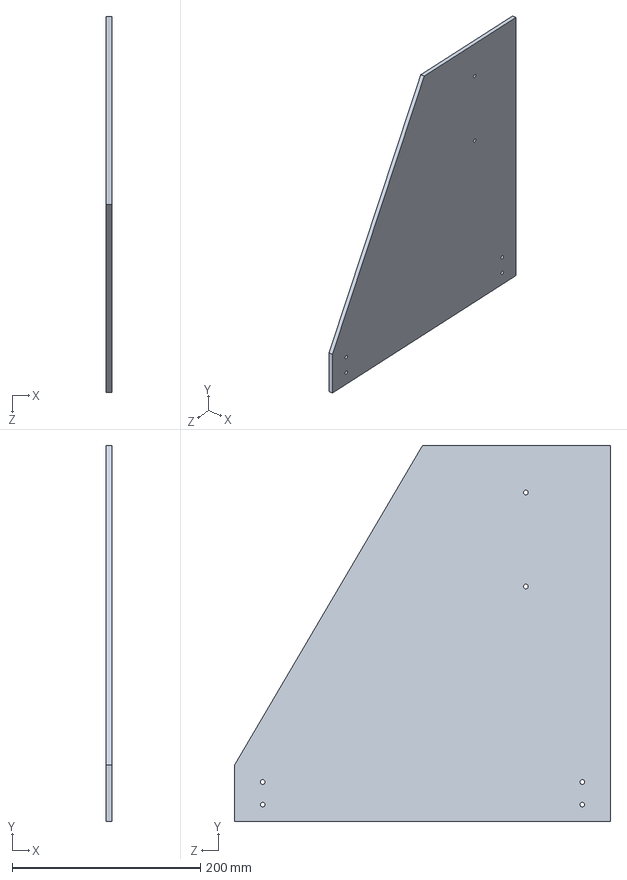
[picture p171: CAD file, 2022-02-13]
Main Frame/X_Side_Raw.SLDPRT
6.00 x 400.0 x 400.0 mm
