MohamedHassan-coder/5-Axis-CNC/(list of files, cad)

Other CAD files:
Motors/Nema 17/Nema 17 .SLDPRT
Collet & Chuck/ER11 Collet Set.step
Chuck/JAW_A.SLDPRT
Main Frame/Y_Stepper_Side.SLDPRT
Control Box/Input_Face.SLDPRT
Main Frame/X_Bearing_Side.SLDPRT
Aluminum Profiles/15180/15180 Aluminum Extrusion.SLDPRT
Bearings/Lead_Screw_End_Support_KFL08.SLDPRT
Collet & Chuck/ER11 - Nut - Type A.SLDPRT
Collet & Chuck/ER11-A Collet Set.SLDPRT
Couplings/CouplingD19L25.SLDPRT
Lead Screw & Nut/LeadScrew 8mm x 2mmPitch.SLDPRT
Lead Screw & Nut/LeadScrew Nut 8mm x 2mmPitch.SLDPRT
Lead Screw & Nut/LeadScrew_Replacement(130 mm).SLDPRT
Lead Screw & Nut/LeadScrew_Replacement.SLDPRT
Lead Screw & Nut/Nut & Housing.SLDASM
Lead Screw & Nut/Screw & Nut .SLDASM
Lead Screw & Nut/Screw & Nut(Replacement).SLDASM
Lead Screw & Nut/t8_nut_housing (1).SLDPRT
Other Parts/Lead Screw Nut_Housing(Y_Axis).SLDPRT
Other Parts/Switch SV-166-1C25.SLDPRT
Other Parts/T-Nut_2020_M5.SLDPRT
