MohamedHassan-coder/5-Axis-CNC/Linear_Guide & Rails/Linear Bearing Rail 20mm 1.0.jpg

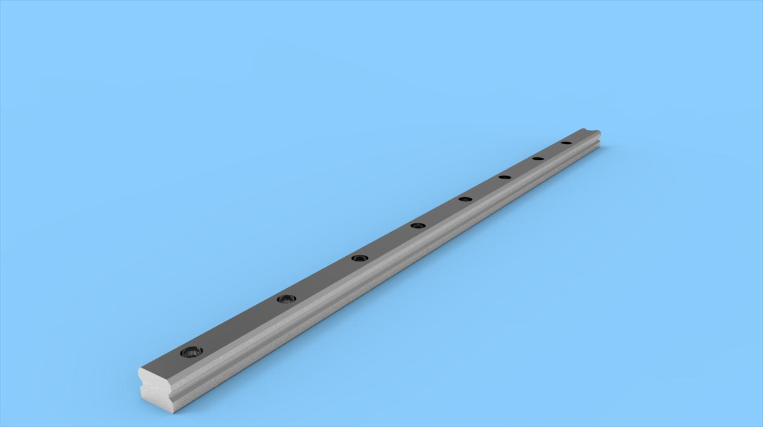
Linear_Guide & Rails/Linear Bearing Rail 20mm 1.0.jpg
