MohamedHassan-coder/5-Axis-CNC/CNC Brochure.pdf

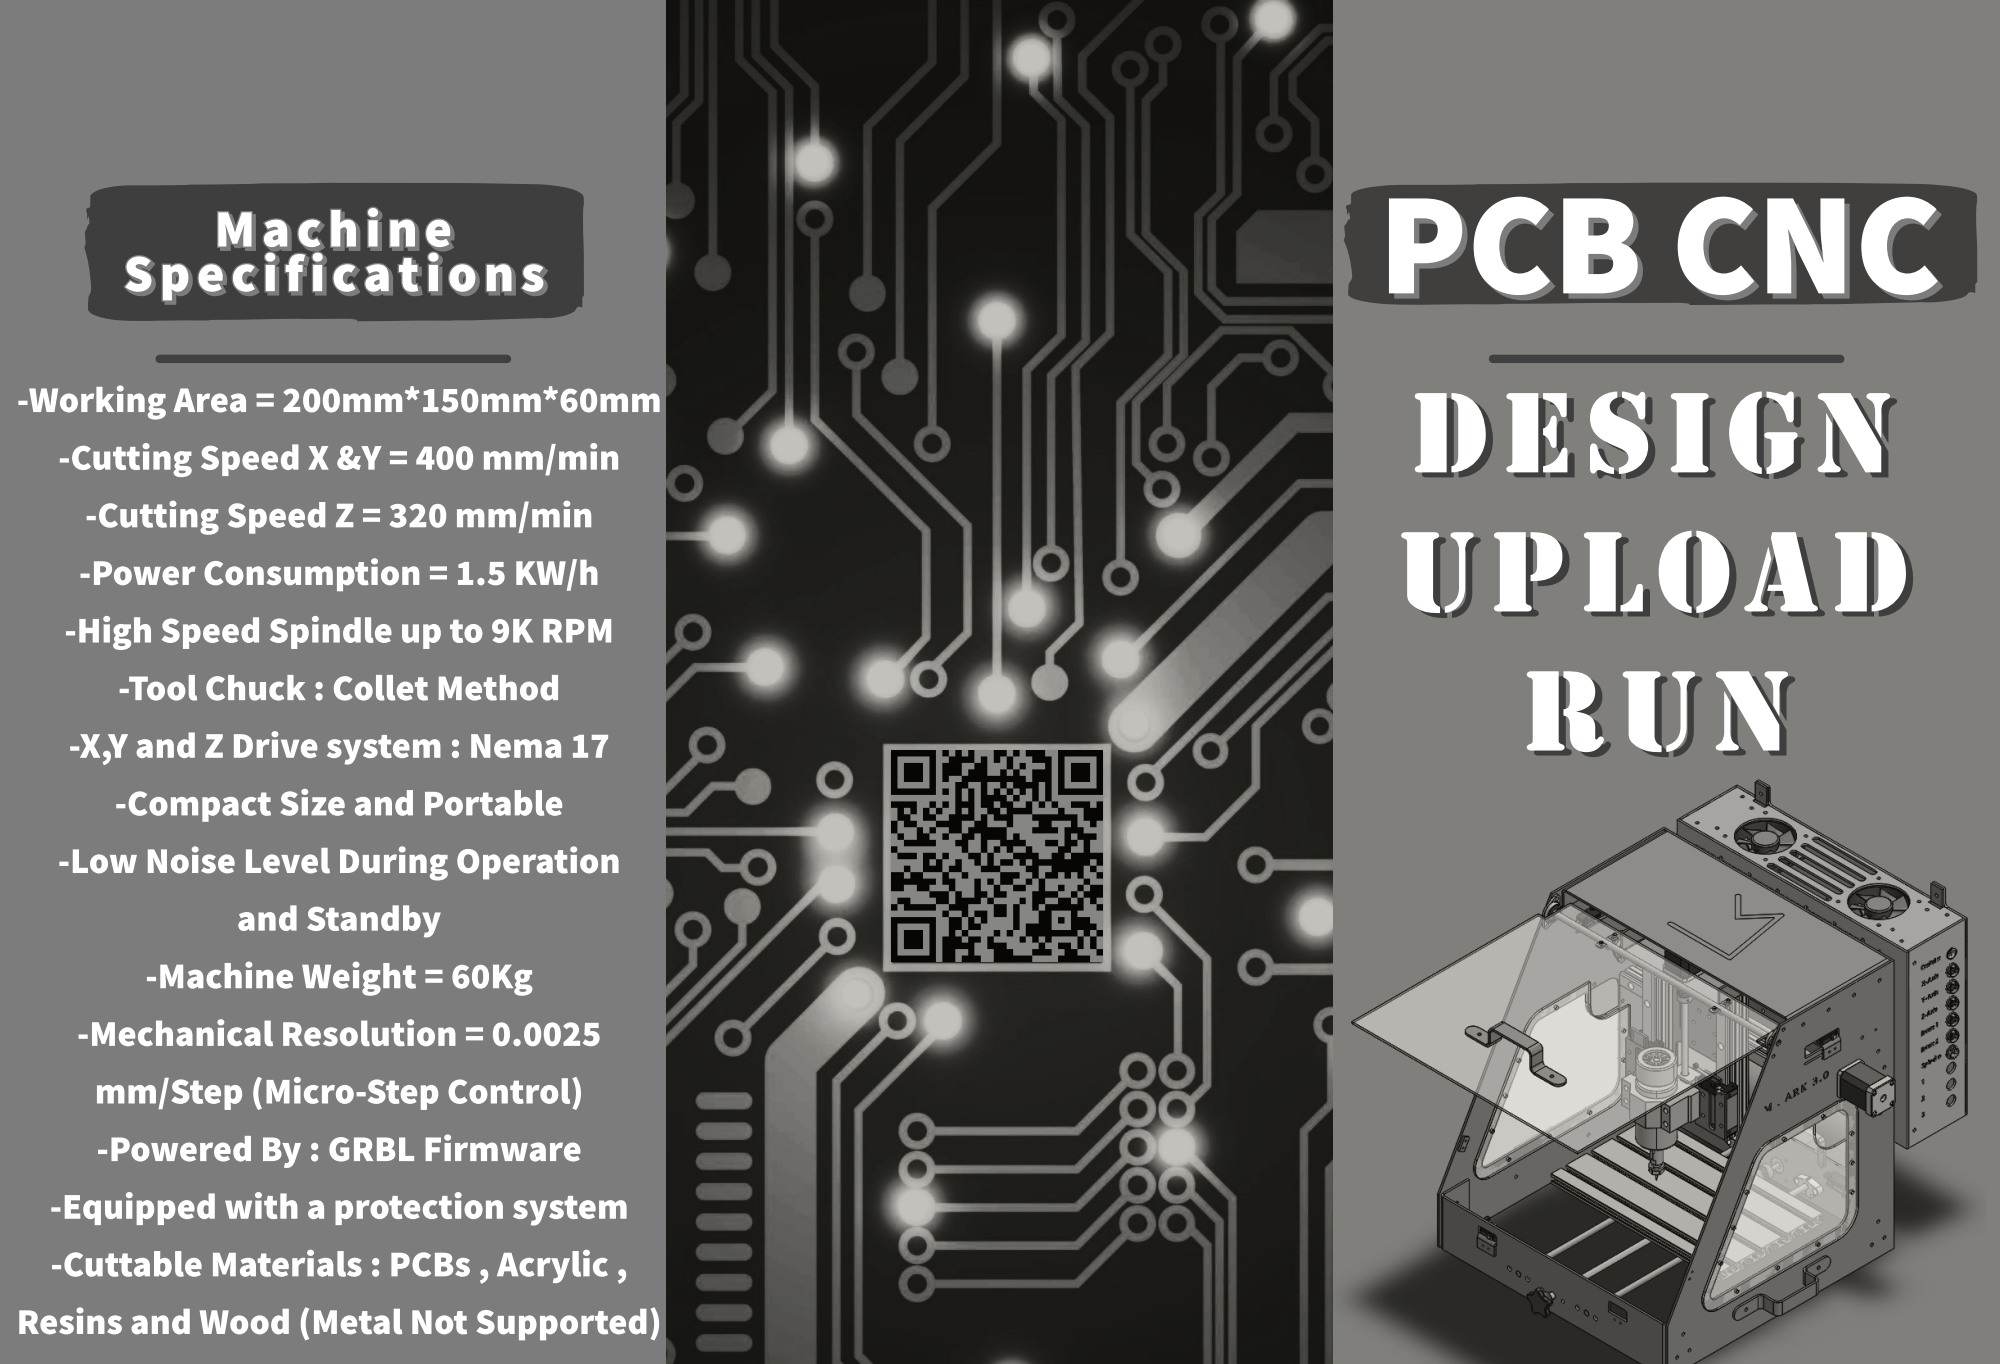
[picture p174: page 1]
