MohamedHassan-coder/5-Axis-CNC/(commit log)

2022-02-12 SetUp The files
    [15180 Aluminum Extrusion.SLDPRT, 2020 alu section.SLDPRT, 3060 Aluminum Extrusion Profile.SLDPRT, 4040 Al Profile.SLDPRT, 608 - 2RS.SLDPRT, Aluminium Extrusion 2040 V-Slot.SLDPRT, ER11 - Collet Chuck.SLDPRT, ER11 - Nut - Type A.SLDPRT]
2022-02-13 Begin to build the main frame and make the Main Assembly
    [Bottom Body.SLDPRT, CouplingD19L25.step, Linear Bearing Block QEH20CA.SLDPRT, Linear Bearing-White Belt.SLDPRT, Linear bearing Rail 20mm.SLDPRT, Main Assembly.SLDASM, Middle Body.SLDPRT, Nema 17 .SLDPRT]
2022-02-14 Modeling the Back and Roof Support and adding it to the assembly
    [Back_Support_Top.SLDPRT, Main Assembly.SLDASM, Roof_Support.SLDPRT, X_Bearing_Side.SLDPRT, X_Stepper_Side.SLDPRT]
2022-02-15 Adding The Following: 1-Linear Bearings for Y Axis 2-Adding lead Screw Support Bearings 3-Adding Couplings 4-Modeling The Y Axis Parts And Add it to the assembly
    [Back_Support_Top.SLDPRT, CouplingD19L25.SLDPRT, Lead_Screw_End_Support_KFL08.SLDPRT, SHF8.SLDPRT, X_Bearing_Side.SLDPRT, Y-Axis_Soft rod.SLDPRT, Y_Bearing_Side.SLDPRT, Y_Stepper_Side.SLDPRT]
2022-02-16 Adding the Moveing mechanism (Screw&Nut) to the assembly
    [LeadScrew 8mm x 2mmPitch.SLDPRT, Screw & Nut .SLDASM]
2022-02-19 Adding the Table and changing the Nut house to a standard Block
    [15180 Aluminum Extrusion.SLDPRT, Aluminium Extrusion 2040 V-Slot(L100mm).SLDPRT, Aluminium Extrusion 2040 V-Slot.SLDPRT, Back_Support_Top.SLDPRT, Cutting_Part.SLDASM, ER11-A Collet Set.SLDPRT, ER11-A Collet Set.STEP, Lead Screw Nut_Housing(X_Axis).SLDPRT]
2022-02-21 Preparing to finish the Assembly
    [2020 alu section (170 mm).SLDPRT, 2020 corner.SLDPRT, 2020 corner.STEP, 2020 corner3.STL, 20X28.step, Back_Support_Top.SLDPRT, Cutting_Part.SLDASM, ER11-A Collet Set.SLDPRT]
2022-02-22 Adding the Aluminum profile supports
    [2020 Fixation.SLDPRT, 2020 alu section (170 mm).SLDPRT, 2020 corner.SLDPRT, 2020 corner.STEP, 2020 corner3.STL, 20X28.step, B18.2.4.1M - Hex nut, Style 1, M5 x 0.8 --D-S.sldprt, B18.3.1M - 5 x 0.8 x 16 Hex SHCS -- 16SHX.sldprt]
2022-02-22 Finishing the Assembly
2022-02-24 Adding the Limit Switches and waiting for the Simulation Result
    [608 - 2RS.SLDPRT, Limit Switch Support .SLDPRT, Limit_SW & Support .SLDASM, Spindle_Base.SLDPRT, Switch SV-166-1C25.SLDPRT, Switch SV-166-1C25.STEP, X_Bearing_Side.SLDPRT, X_Stepper_Side.SLDPRT]
2022-02-25 Adding the A & C Axis Extension
    [A-Axis Motor Base .SLDPRT, A-Axis Motor Base(SM).SLDPRT, C-Axis Assembly.SLDASM, C-Axis Base.SLDPRT, C-Axis Rotate Part.SLDPRT, assembled jaw.stp]
2022-02-25 Making a copy of the frame Assembly for the Simulation
    [Frame Assembly(For Simulation).SLDASM]
2022-02-26 Making the Following Changes: 1- Reducing Z-Axis Weight by about 250 grams 2- Editing the Roof Support 3- Making Sdde Pannels in the X-Axis to view the current Working Jop 4- Making the Main parts of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
    [Back_Support_Top.SLDPRT, Door_Base_Part.SLDPRT, Door_Roof.SLDPRT, Frame Assembly(For Simulation).SLDASM, Front_Panel.SLDPRT, Roof_Support.SLDPRT, Side_Panel.SLDPRT, Spindle_Base.SLDPRT]
2022-02-27 Changing the Door and the Encloser of the Machine to be more Efficient and easier to be manufactured
    [Door.SLDPRT, Door_Base_Part.SLDPRT, Door_Hinge.SLDPRT, Door_Roof.SLDPRT, Door_Stopper.SLDPRT, Front_Buttom.SLDPRT, Front_Panel.SLDPRT, X_Bearing_Side.SLDPRT]
2022-02-28 1- Editing The Rotation Mechanism for the Door. 2- Adding 2 Handle to Lift up the Machine. 3- Adding 2 Additional side Paneles To Reduce the Noise (Made From Acrilic). 4- Adding A Back Acrilic Panel 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
    [Back_Panel.SLDPRT, Back_Panel_Support.SLDPRT, Back_Support_Top.SLDPRT, Door.SLDPRT, Door_Hinge.SLDPRT, Door_Rotation_Shaft.SLDPRT, Handle.SLDPRT, Lead_Screw_End_Support_KFL08.SLDPRT]
2022-02-28 Fully Enclose the Frame.
    [Back_Support_Top.SLDPRT, Roof_Support.SLDPRT, Screw_Handle.SLDPRT, Side_Panel.SLDPRT, Side_Panel_inside.SLDPRT, X_Bearing_Side.SLDPRT, X_Stepper_Side.SLDPRT]
2022-03-01 1- Modeling the WP Chuck. 2- Adding t=the chuck to the 5 Axis Extension Assembly
    [C-Axis Assembly.SLDASM, Chuck.SLDASM, Housing.SLDPRT, JAW_A.SLDPRT, JAW_B.SLDPRT, JAW_C.SLDPRT, Ring.SLDPRT, Scroll_Plate.SLDPRT]
2022-03-01 1- Adding the pulleys to the 5 Axis Extension. 2- Adding the A & C Axis To the Main Assembly. 3- Adding Material For Some Parts.
    [A-Axis Assembly.SLDASM, C-Axis Assembly.SLDASM, C-Axis Rod1.SLDPRT, C-Axis Rod2.SLDPRT, C-Axis Rotate Part.SLDPRT, Chuck.SLDASM, GT2 36T id 5mm bw 6mm.SLDPRT, GT2 60T id 8mm bw 6mm.SLDPRT]
2022-03-02 1- Renforce The C Axis Housing With A Screw in the center
    [C-Axis Assembly.SLDASM, Chuck.SLDASM, Housing.SLDPRT, WP.SLDPRT]
2022-03-03 -Change the pulleys of the A and C axes to suit the available belts in the local market (200mm GT2)
    [A-Axis Assembly.SLDASM, A-Axis Motor Base(SM).SLDPRT, C-Axis Assembly.SLDASM, C-Axis Base.SLDPRT, C-Axis Rod2.SLDPRT, C-Axis Rotate Part.SLDPRT, GT2 36T id 5mm bw 6mm.SLDPRT, GT2_20T-sh8.SLDPRT]
2022-03-04 -Begin designing the conttrolle box of the machine which will contain the main controller , motor drivers ,power suupply and motors connections
    [8412NGLE_EBM-PAPST.SLDPRT, ArduinoMega.SLDPRT, Base.SLDPRT, Button Red.SLDPRT, Fused AC Male Power Socket.SLDPRT, Input_Face.SLDPRT]
2022-03-04 -Making the Control Box and add it to the main assembly.
    [Back_Support_Top.SLDPRT, Base.SLDPRT, Cotrolle_Face.SLDPRT, Fan_Side.SLDPRT, Fixation_2_M-C.SLDPRT, GT2 36T id 5mm bw 6mm.SLDPRT, GX-16 Connector 2 Pins.SLDPRT, GX-16 Connector 4 Pins.SLDPRT]
2022-03-04 -Finishing the main control box.
    [Back_Support_Top.SLDPRT, Base.SLDPRT, Cotrolle_Face.SLDPRT, Cover.SLDPRT, Input_Face.SLDPRT, Limit_SW_Side.SLDPRT, Limit_Switches_Assembly.SLDASM, Roof_Support.SLDPRT]
2022-03-04 -Adding the WP fixation.
    [WP_Fixation.SLDPRT]
2022-07-14 Finishing the Project and the Documentation(Last Commit ISA)
    [15180 Aluminum Extrusion.SLDPRT, 2020 Fixation.SLDPRT, 3060 Aluminum Extrusion Profile.SLDPRT, 4040 Al Profile.SLDPRT, 608 - 2RS.SLDPRT, A-Axis Assembly.SLDASM, A-Axis Motor Base .SLDPRT, A-Axis Motor Base(SM).SLDPRT]
